zuhayrl/EEE4022S_Thesis/FinalReport/Main.tex

% Zuhayr Loonat - University of Cape Town - LNTZUH001
% This is a project report templace document created for EEE4022FS students at the University of Cape Town.
% This file should be is processed with ``pdflatex`` and might need a few modifications if a different processor is chosen.
% Use pdflatex - bibtex - pdf latex - pdflatex

\documentclass[a4paper,12pt]{report}

%Include packages you need to use here

\usepackage[top = 1in, bottom = 1in, left = 1in, right = 1in]{geometry}
\usepackage{graphicx}
\usepackage{fancyhdr}
\usepackage{amsmath, amsthm, amssymb}
\usepackage{lastpage}
\usepackage{subfigure}
\usepackage{lscape}
\usepackage{hyphenat}
\usepackage{setspace}
\usepackage{hyperref}
\usepackage{siunitx}
\usepackage{array}
\usepackage{float}

% Glossary package
% \usepackage[acronyms]{glossaries}
% \setacronymstyle{long-short}
\usepackage[acronym]{glossaries-extra}
\setabbreviationstyle[acronym]{long-short}
% \renewcommand{\acronymname}{Glossary}
\makenoidxglossaries

% Include glossary definitions
\input{glossary}

% Include page formatting here. 
\parskip=6mm
\parindent=0mm
\renewcommand{\headrulewidth}{0pt}
\rhead[]{\thesection}
\lhead[\thechapter]{}

\begin{document}

% This section formats the title page of the Report.
\thispagestyle{empty}
    {\Huge \begin{center}
        % Modify the line below to insert your title.
        The Measurement of Water Salinity \\for Antarctic Research
        %\hrule 
        % Modify the line below to insert your subtitle.
        %{\Large Insert a subtitle here (if applicable)}
    \end{center}}

    \vskip 5mm
    \begin{center}
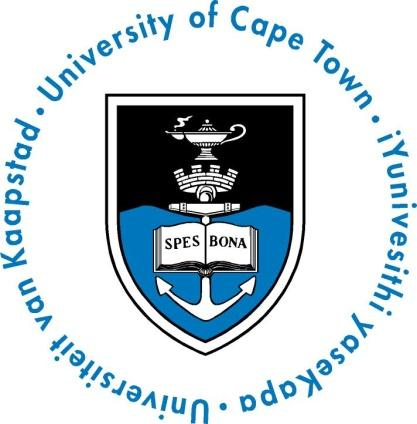
[picture p1: FinalReport/Figures/uctLogo.png]
        
    \end{center}

    \vskip 5mm
    \begin{center}
        Presented by:\\
        Zuhayr Loonat		% Insert your name here
    \end{center}

    \vskip 10mm
    \begin{center}
        Prepared for:\\
        Justin Pead\\ 		% Insert your supervisor's name here.
        Dept.~of Electrical Engineering\\University of Cape Town
    \end{center}

    \vskip 10mm
    \begin{center}
        Submitted to the Department of Electrical Engineering at the University of Cape Town in partial
        fulfillment of the academic requirements for a Bachelor of Science degree in Electrical and Computer Engineering
    \end{center}

    \vskip 5mm
    \begin{center}
        {\bf \today}
    \end{center}

%second Page
%\newpage
%\thispagestyle{empty}
%\mbox{}

% Declarartion
\fancyfoot[C]{\thepage}
\pagestyle{plain}
\newpage
\pagenumbering{roman}
%\newpage
    \onehalfspacing{
    \nohyphens{
    %\thispagestyle{empty}
    \vskip 40mm

    % Please leave the declaration as it is (Standard UCT declaration).
    {\Huge{Declaration}}\\
    %\hrule

    \vskip 10mm
    \begin{enumerate}
        \item I know that plagiarism is wrong.
        Plagiarism is to use another's work and pretend that it is one's own.
        \item I have used the IEEE convention for citation and referencing.
        Each contribution to, and quotation in, this report `The Measurement of Water Salinity for Antarctic Research' from the work{(s)} of other people has been attributed and has been cited and referenced.
        Any section taken from an internet source has been referenced to that source.
        \item This report `The Measurement of Water Salinity for Antarctic Research' is my own work and is in my own words (except where I have attributed it to others).
        \item I have not paid a third party to complete my work on my behalf.
        My use of artificial intelligence software has been limited to giving overviews of topics, checking grammar, and aiding with {\LaTeX} commands.
        \item I have not allowed and will not allow anyone to copy my work with the intention of passing it off as his or her own work.
        \item I acknowledge that copying someone else's assignment or essay, or part of it, is wrong, and declare that this is my own work
    \end{enumerate}
    \vskip30mm
        \begin{tabular*}{\textwidth}{@{}l@{\extracolsep{\fill}}r@{}}
        Signature:\ldots\ldots\ldots\ldots\ldots\ldots\ldots\ldots\ldots & Date: {\today} \\
        Zuhayr Loonat & \\
        Word Count: 10851& \\
        \end{tabular*}
        \vskip10mm

%\newpage
    %\thispagestyle{empty}
    %{\Huge Terms of Reference}\\
    %\hrule
    %\vskip 10mm
    %The terms of reference page is an agreement between yourself and your supervisor outlining what is expected of you in your final year project. Please make sure that this is discussed and written at the beginning of your thesis project. 

%\fancyfoot[C]{\thepage}
%\pagestyle{plain}
%\pagenumbering{roman}
\newpage
{\Huge Acknowledgments}\\
%\hrule
\vskip 10mm
I would like to express my sincere gratitude to my supervisor, Justin Pead, for his invaluable guidance, support, and expertise throughout this research.
His insights and encouragement were instrumental in bringing this work to fruition.

I am also deeply grateful to my friends for their unwavering moral support during this journey.
Their encouragement and understanding made the challenges of this process far more manageable.

Lastly, I would like to thank my family for their support during my studies.

\newpage
    {\Huge Abstract}\\
    %\hrule
    \vskip 10mm

    % Place your abstract here.
    Ice shelves form when glaciers flow from the Antarctic out over the ocean.
    This ice, which is originally freshwater ice is formed from accumulated snow, extends over the water and floats, because ice is less dense than water.
    When saltwater freezes at the bottom of the ice shelves, salt is expelled, forming a brine like solution, with a high salt density, directly under the ice shelves.

    The salinity of this brine solution and the seawater underneath need to be measured to aid in Antarctic research.
    This project documents the design and testing of a conductivity-based salinity measuring device to measure the salt content in these areas.
    The prototype was designed in two parts, a probe module, which would be lowered down through a water tower, which was drilled into the ice shelves, to measure the salinity, and a controller, which would be used to send instructions and receive data from the probe.
    The probe utilised gold electrodes to measure and analyse the salinity through conductivity.
    Two methods were investigated,~\gls{dc}, where point voltage measurements and voltage sweeps were conducted, and~\gls{ac} where a machine learning model was used to map properties of the input and output waves to a salinity value.
    The \gls{dc} method, using conductivity via resistance measurements over two probes, were able to produce salinity measurements within $\pm3.5$ \gls{psu}, but were subject to error and noise.
    The random forest algorithm used to predict permittivity of a Resistor-Capacitor circuit showed feasibility for salinity prediction use, where it showed capability for learning the physics, not just predicting based on random correlations.
    This feature identification carried over well, into the salinity prediction model. However, the prediction capabilities of this model were limited by the small dataset.

    With further testing, both the \gls{dc}, and \gls{ac} techniques could be improved to show more accurate results.

%\newpage
    %{\Huge Glossary}\\
    %\hrule
    %\vskip 10mm
    
    %\glsaddall

\newpage
    \tableofcontents

%\newpage
%\listoffigures

%\newpage
%\listoftables

% Page formatting, to place section titles as headers of odd pages and Chapter titles as headers of even pages.
%\newpage
%\fancyhead[RE,LO]{}
%\fancyhead[LE]{\leftmark}
%\fancyhead[RO]{\rightmark}
\pagestyle{fancy}

\pagenumbering{arabic}

% Print Glossary/Acronyms
\renewcommand{\acronymname}{Glossary}
\printnoidxglossaries

% THe files included below are .tex files containing the respective chapters these are already created in this package and you can add to or modify them.
\include{Body/Introduction}
\include{Body/Literature}
\include{Body/Methodology}
\include{Body/Results}
%\include{Body/Discussion}
\include{Body/Conclusions}
\include{Body/Recommendations}
\include{Referencing/References}
\appendix
\include{Appendix/appendixa}
\include{Appendix/appendixb}
\include{Appendix/appendixc}
}} % for nohyphens and line spacing
\end{document}
