zuhayrl/EEE4022S_Thesis/FinalReport/glossary.tex

% Glossary definitions for the thesis
% This file contains all glossary entries used throughout the document

% Physical quantities and units
\newacronym{psu}{PSU}{Practical Salinity Unit}
\newacronym{ppt}{‰}{Parts per thousand}

% Acronyms
\newacronym{eis}{EIS}{Electrochemical Impedance Spectroscopy}
\newacronym{ml}{ML}{Machine Learning}
\newacronym[shortplural=CTDs]{ctd}{CTD}{Conductivity, Temperature, Depth}
\newacronym[shortplural=PCBs]{pcb}{PCB}{Printed Circuit Board}
\newacronym{enig}{ENIG}{Electroless Nickel Immersion Gold}
\newacronym[shortplural=ADCs]{adc}{ADC}{Analogue to Digital Converter}
\newacronym[shortplural=DACs]{dac}{DAC}{Digital to Analogue Converter}
\newacronym{ac}{AC}{Alternating Current}
\newacronym{dc}{DC}{Direct Current}
\newacronym{ic}{IC}{Integrated Circuit}
\newacronym{uart}{UART}{Universal Asynchronous Receiver-Transmitter}
\newacronym{led}{LED}{Light Emitting Diode}
\newacronym[shortplural=EECs, longplural={Equivalent Electrical Circuits}]{eec}{EEC}{Equivalent Electrical Circuit}
\newacronym[shortplural=ANNs, longplural={Artificial Neural Networks}]{ann}{ANN}{Artificial Neural Network}
