zuhayrl/EEE4022S_Thesis/FinalReport/Appendix/appendixb.tex

\chapter{Addenda}

\section{Examples of AI Usage}

\begin{figure}[H]
    \centering
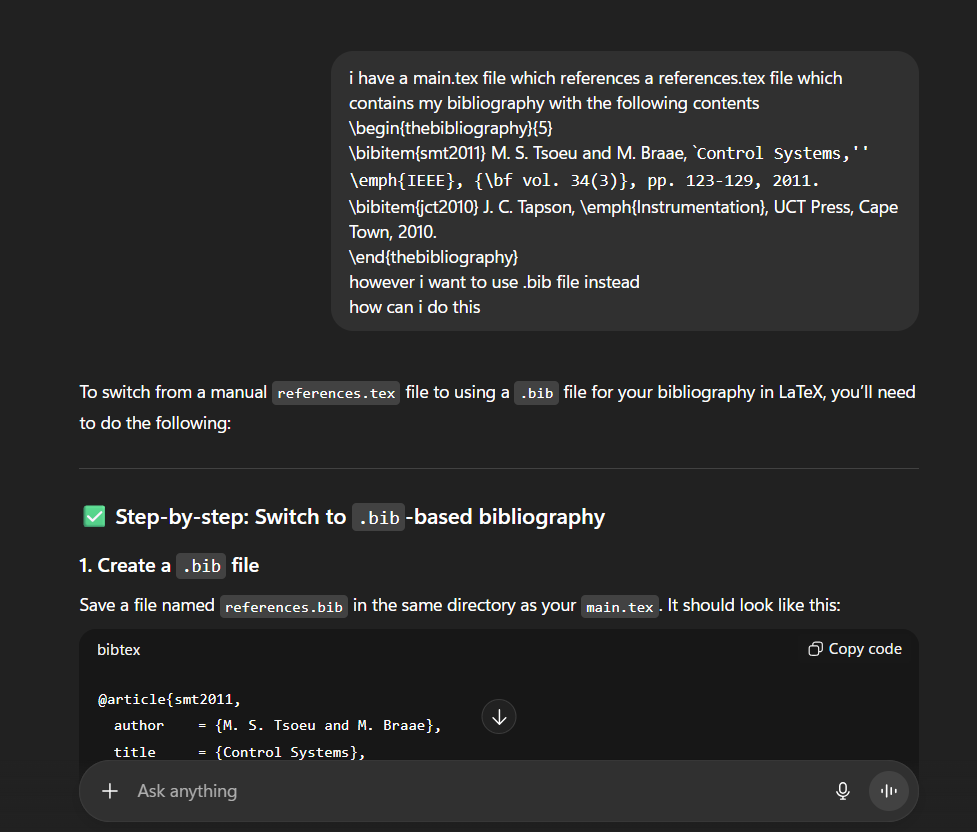
[picture p12: FinalReport/Figures/AI_Usage/Bib_file.png]
    
    \caption{Latex Referencing}
\end{figure}

\begin{figure}[H]
    \centering
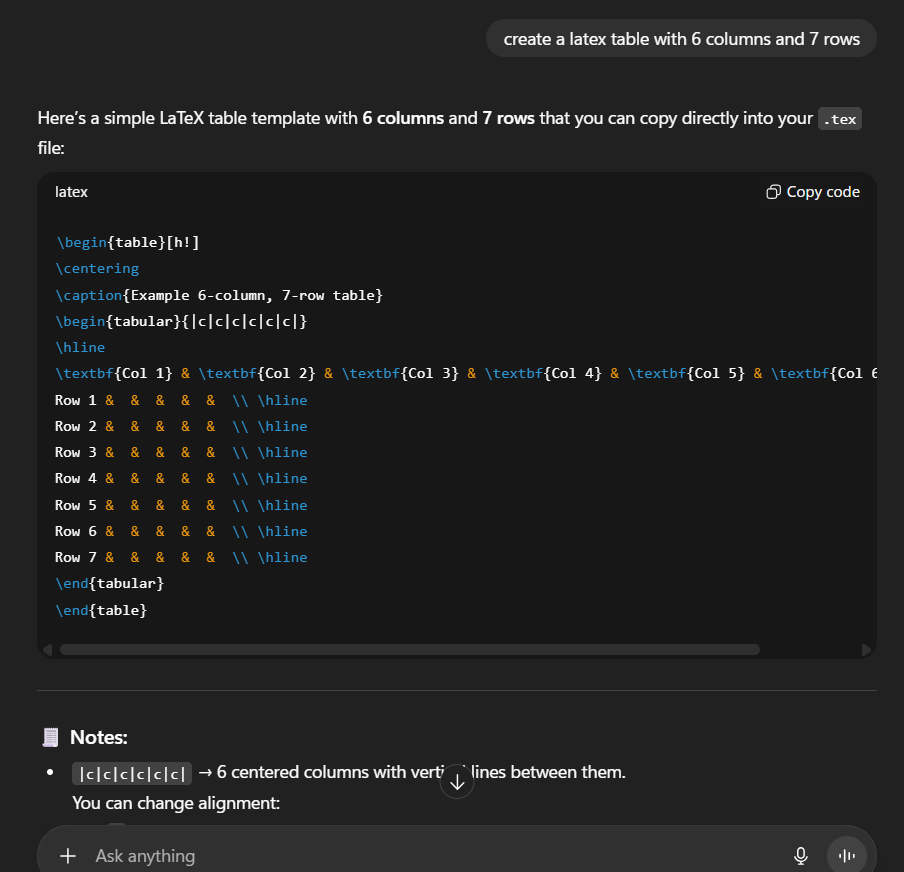
[picture p13: FinalReport/Figures/AI_Usage/latex_table.png]
    
    \caption{Latex Formatting}
\end{figure}

\begin{figure}[H]
    \centering
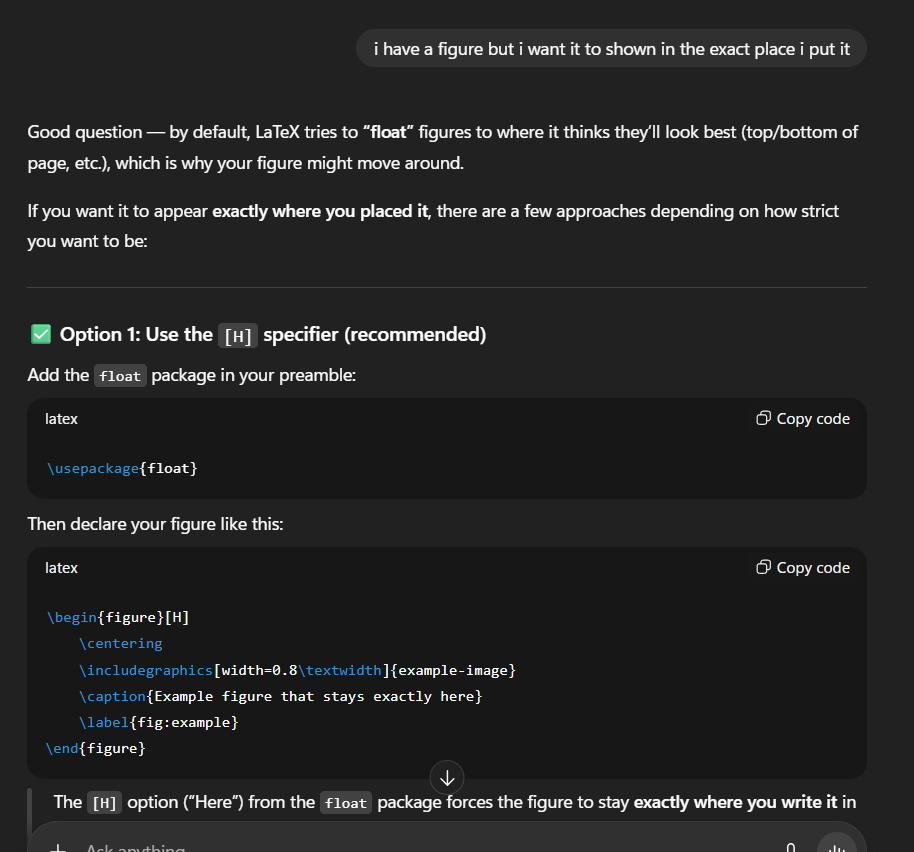
[picture p14: FinalReport/Figures/AI_Usage/latex_figure.png]
    
    \caption{Latex Formatting}
\end{figure}

\begin{figure}[H]
    \centering
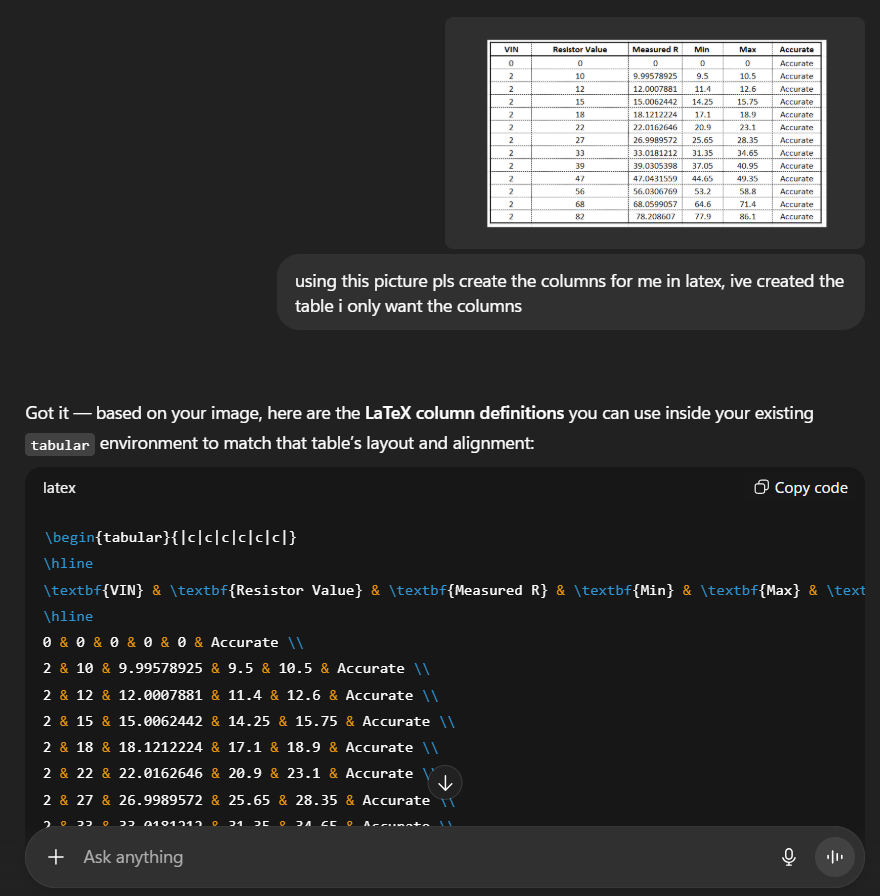
[picture p15: FinalReport/Figures/AI_Usage/latex_pic.png]
    
    \caption{Latex Formatting}
\end{figure}

\begin{figure}[H]
    \centering
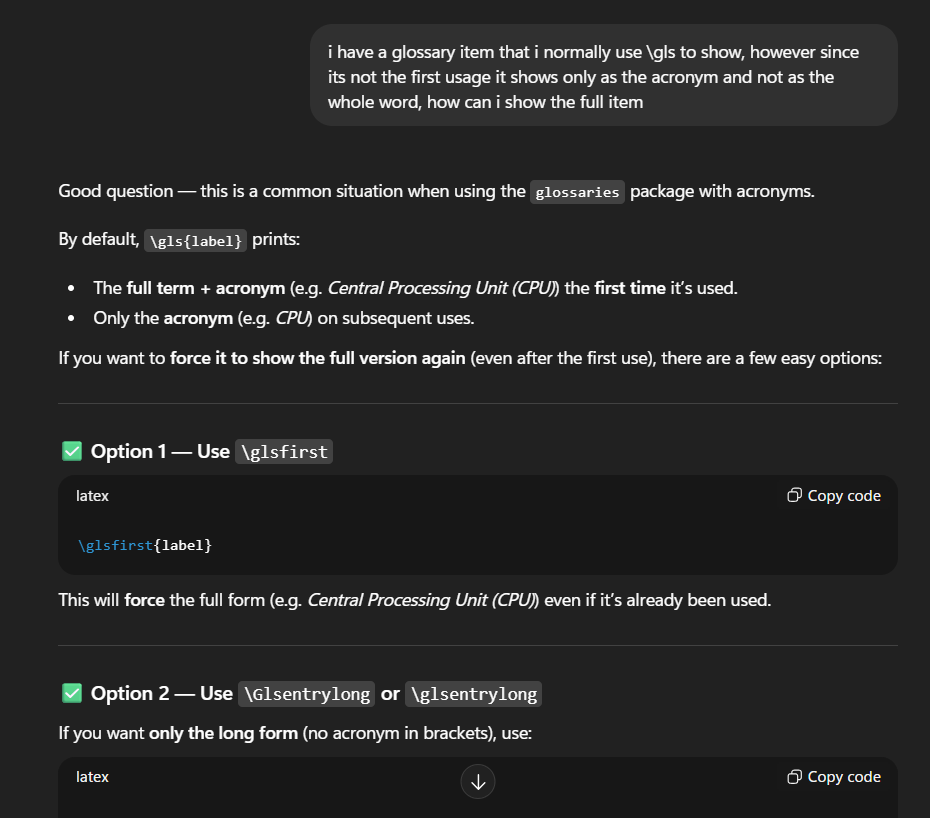
[picture p16: FinalReport/Figures/AI_Usage/latex_gls.png]
    
    \caption{Latex Formatting}
\end{figure}

\begin{figure}[H]
    \centering
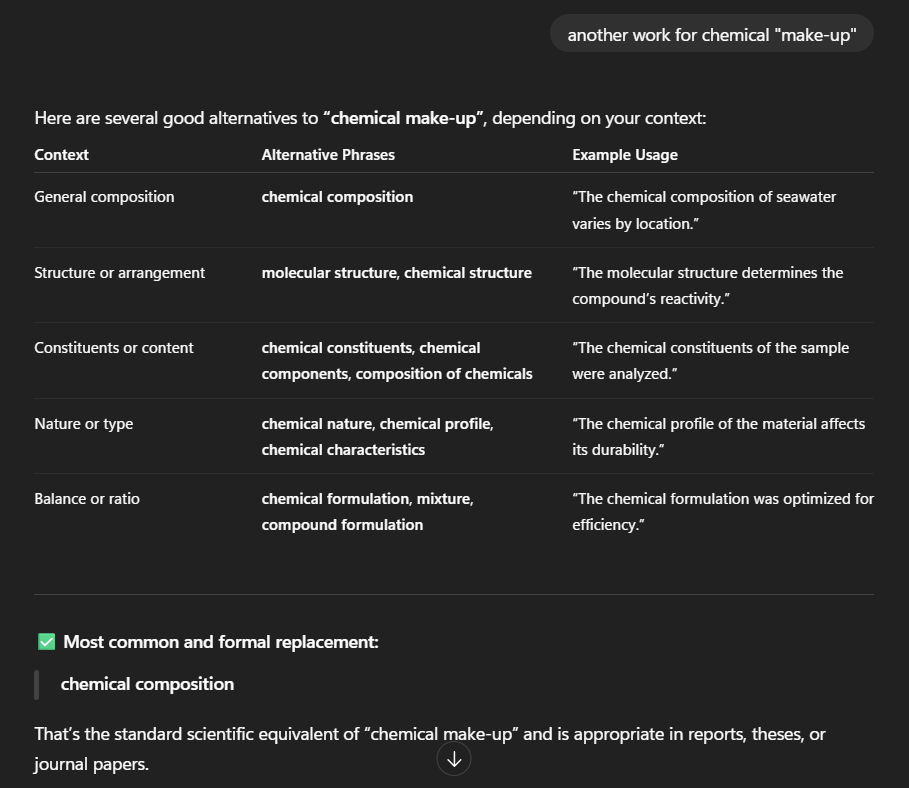
[picture p17: FinalReport/Figures/AI_Usage/grammar1.png]
    
    \caption{Grammar}
    \textit{Note: Grammarly was also used for spelling and grammar checks}
\end{figure}

\begin{figure}[H]
    \centering
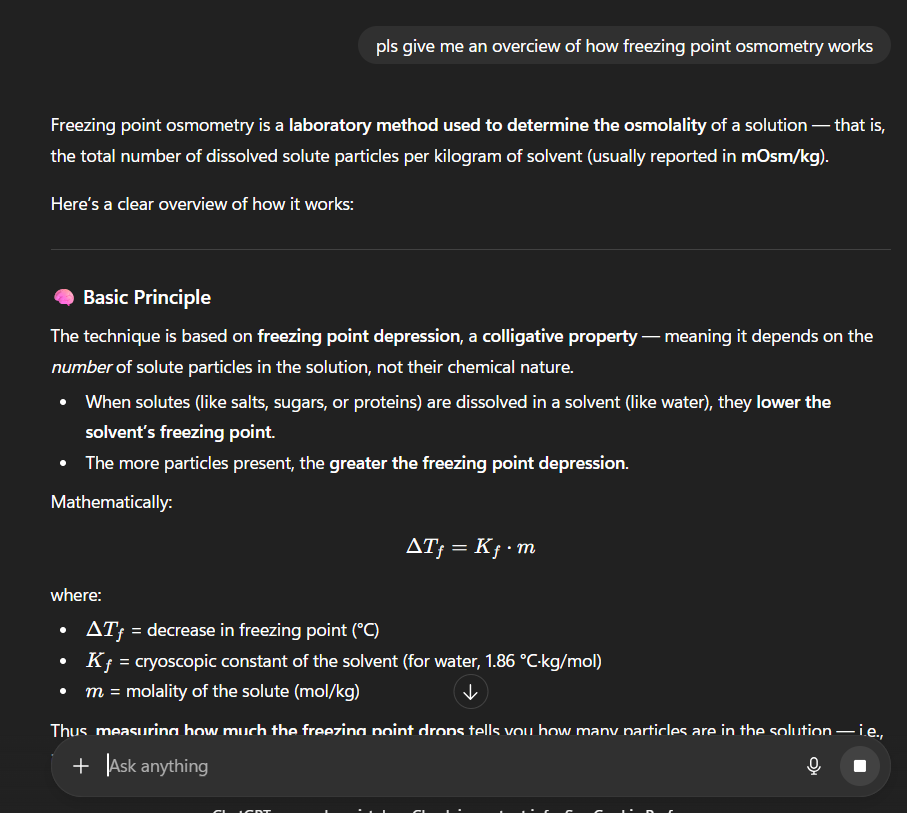
[picture p18: FinalReport/Figures/AI_Usage/freezing_overview.png]
    
    \caption{Topic Overview}
\end{figure}

\begin{figure}[H]
    \centering
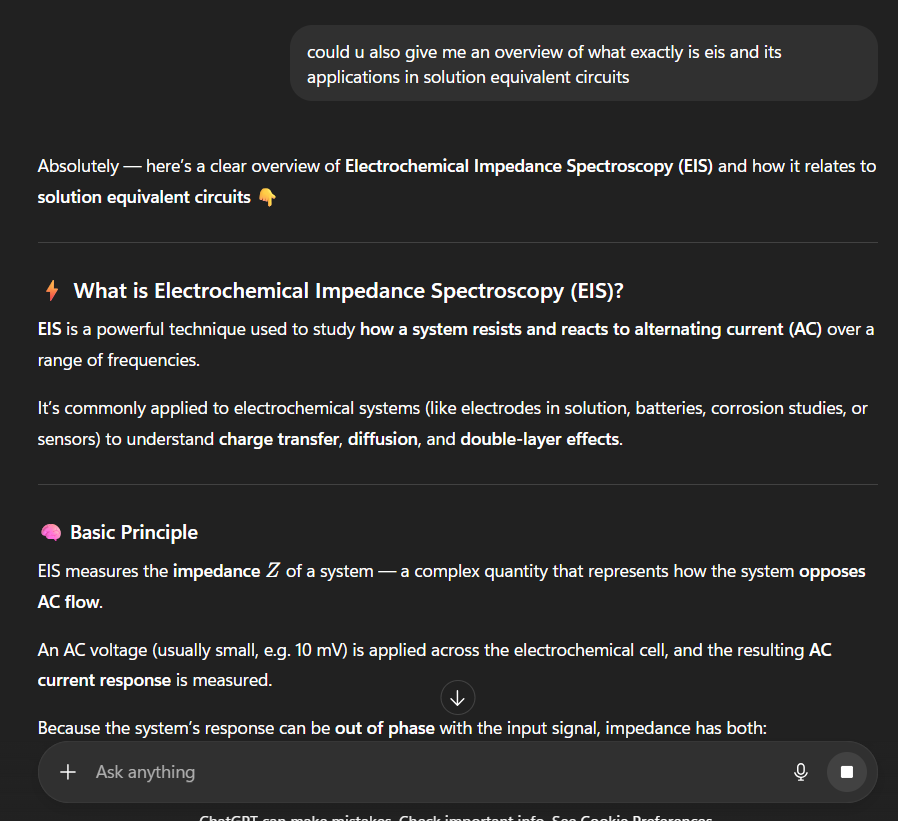
[picture p19: FinalReport/Figures/AI_Usage/eis_overview.png]
    
    \caption{Topic Overview}
\end{figure}
