zuhayrl/EEE4022S_Thesis/PCB/Order/Total.png

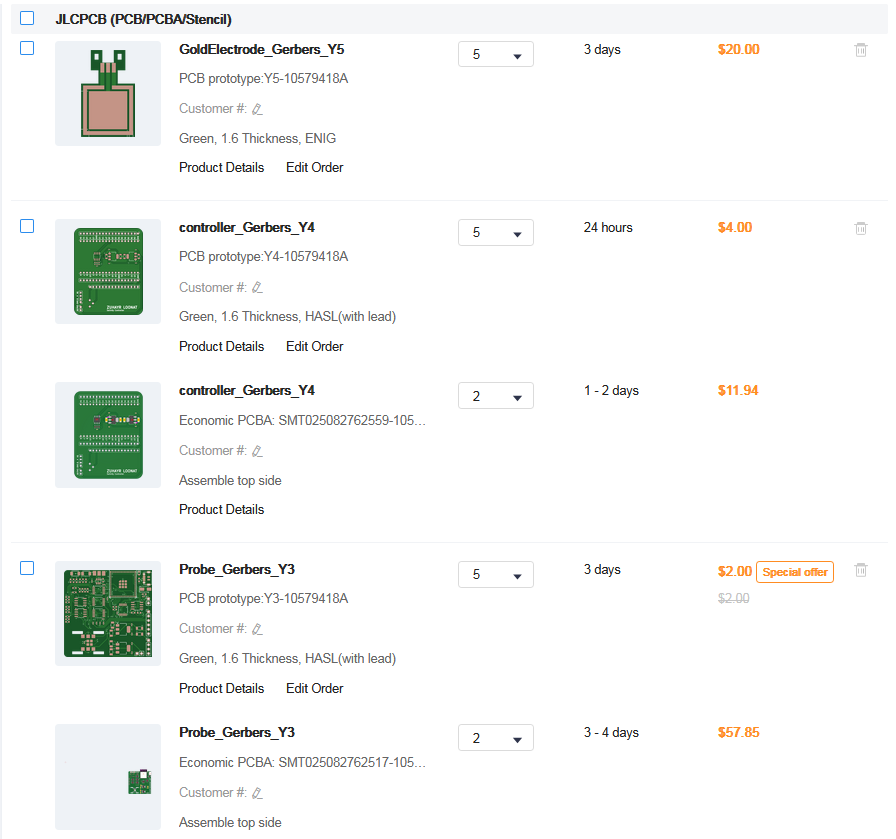
PCB/Order/Total.png
