zuhayrl/EEE4022S_Thesis/Testing/SalinityTesting.xlsx

Sheet: DAC Testing
Instructed | Multimeter | Gain | ADC UNB | Calib | Gain | ADC DAC | Calib | Gain
0.0 | 0.0098 | 0.00980 | 0.003 | 0 | 0.00300 | 0.004 | 0 | 0.00400
0.1 | 0.1158 | 1.15800 | 0.157 | 0.6369426752 | 1.57000 | 0.143 | 0.6993006993 | 1.43000
0.2 | 0.2158 | 1.07900 | 0.279 | 0.7168458781 | 1.39500 | 0.269 | 0.7434944238 | 1.34500
0.3 | 0.3158 | 1.05267 | 0.396 | 0.7575757576 | 1.32000 | 0.391 | 0.7672634271 | 1.30333
0.4 | 0.413 | 1.03250 | 0.533 | 0.7504690432 | 1.33250 | 0.517 | 0.7736943907 | 1.29250
0.5 | 0.51 | 1.02000 | 0.658 | 0.7598784195 | 1.31600 | 0.648 | 0.7716049383 | 1.29600
0.6 | 0.612 | 1.02000 | 0.781 | 0.7682458387 | 1.30167 | 0.77 | 0.7792207792 | 1.28333
0.7 | 0.711 | 1.01571 | 0.909 | 0.7700770077 | 1.29857 | 0.898 | 0.7795100223 | 1.28286
0.8 | 0.81 | 1.01250 | 1.031 | 0.7759456838 | 1.28875 | 1.021 | 0.7835455436 | 1.27625
0.9 | 0.899 | 0.99889 | 1.152 | 0.78125 | 1.28000 | 1.145 | 0.7860262009 | 1.27222
1.0 | 1.005 | 1.00500 | 1.27 | 0.7874015748 | 1.27000 | 1.268 | 0.7886435331 | 1.26800
1.1 | 1.103 | 1.00273 | 1.404 | 0.7834757835 | 1.27636 | 1.394 | 0.7890961263 | 1.26727
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
