zuhayrl/EEE4022S_Thesis/FinalReport/Figures/resistance_test_table.png

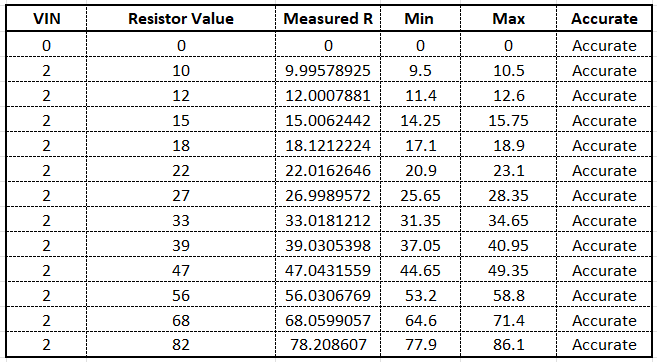
FinalReport/Figures/resistance_test_table.png
