zuhayrl/EEE4022S_Thesis/MachineLearning/Salinity_ML/salinity_model_results.png

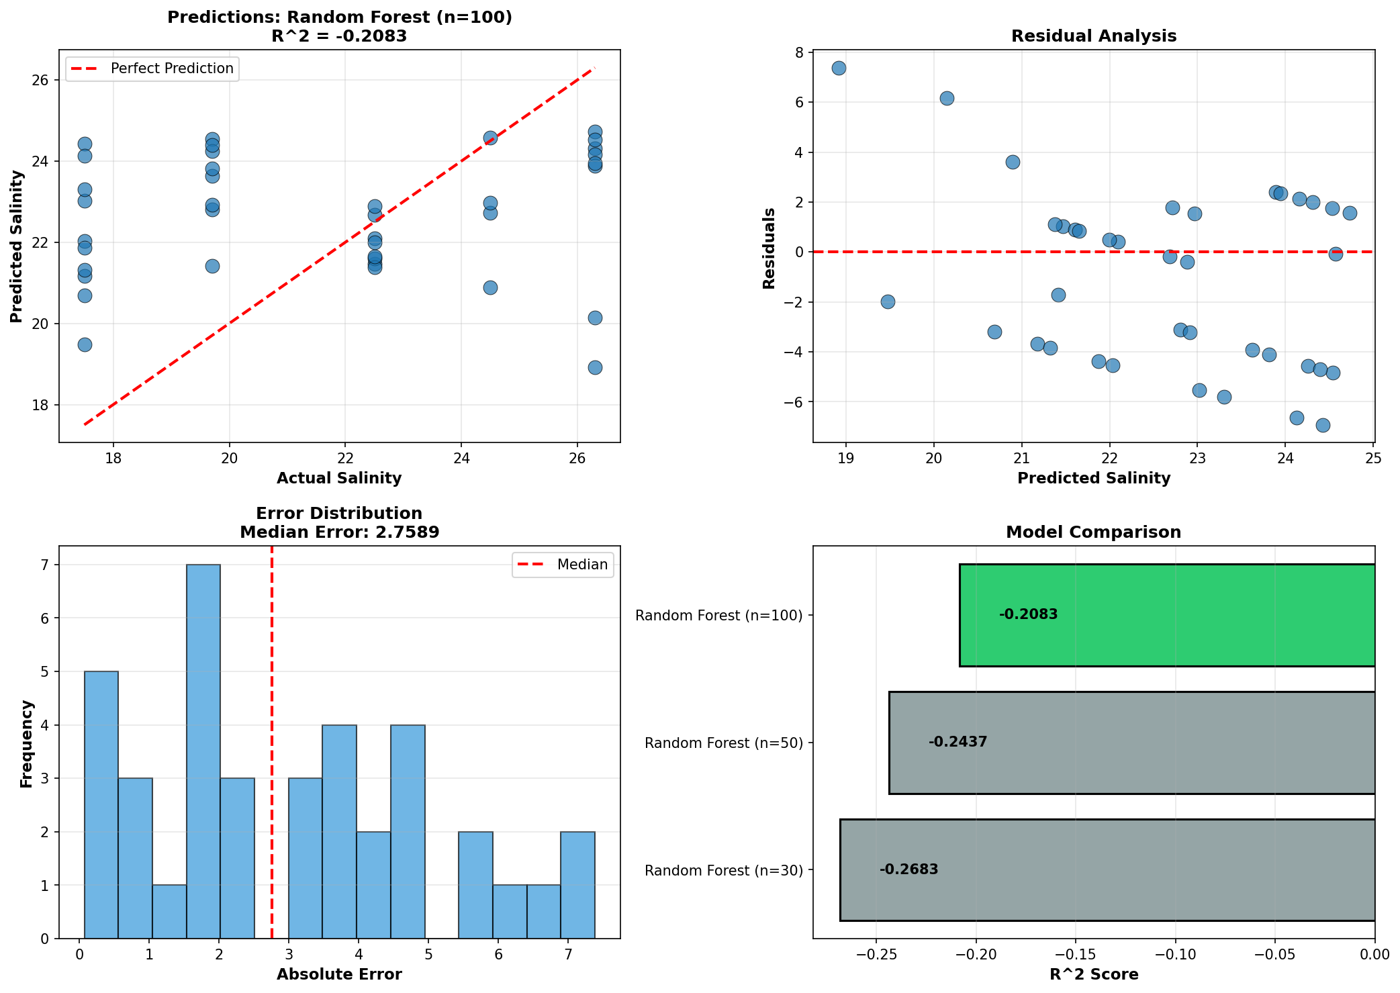
MachineLearning/Salinity_ML/salinity_model_results.png
