zuhayrl/EEE4022S_Thesis/Testing/Bode/1hz.png

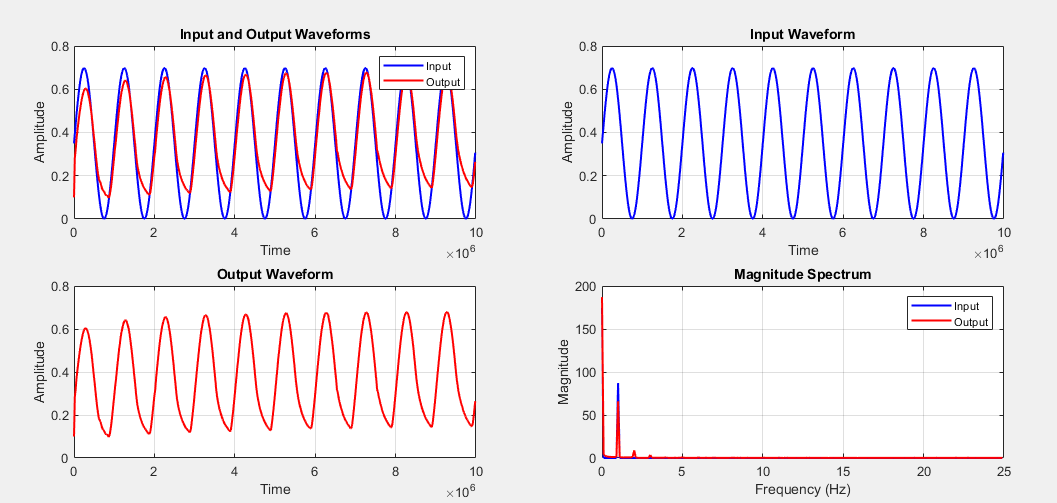
Testing/Bode/1hz.png
