zuhayrl/EEE4022S_Thesis/Testing/Bode/2hz.png

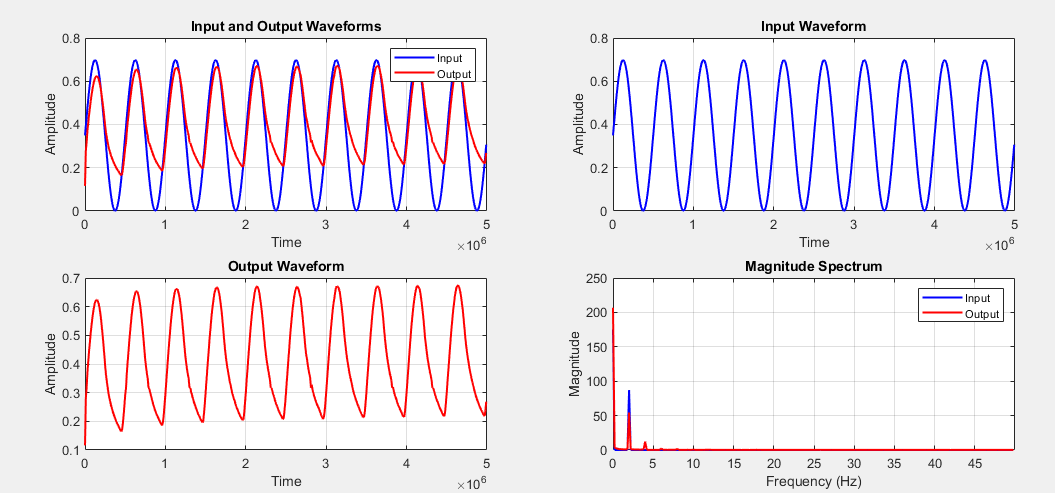
Testing/Bode/2hz.png
