zuhayrl/EEE4022S_Thesis/Testing/Bode/3hz.png

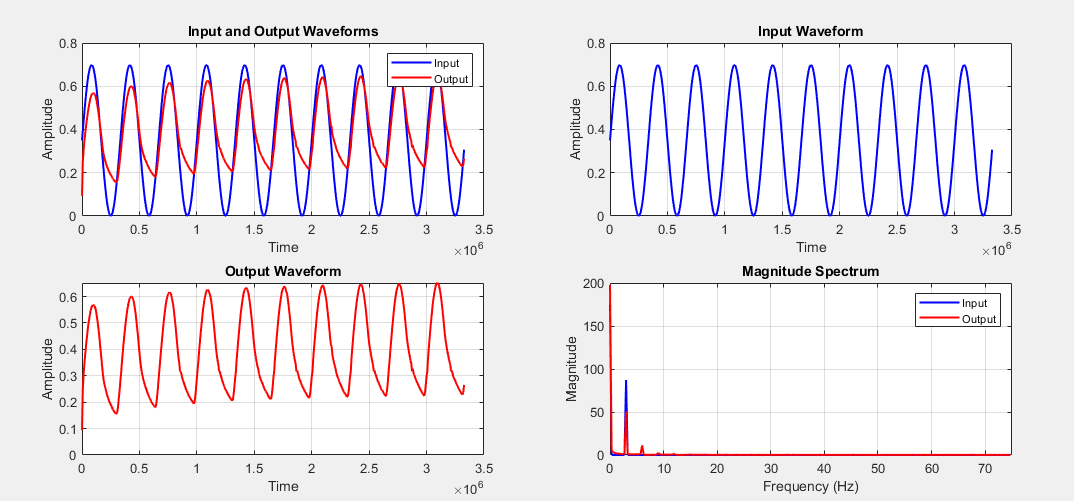
Testing/Bode/3hz.png
