zuhayrl/EEE4022S_Thesis/Testing/Bode/4hz.png

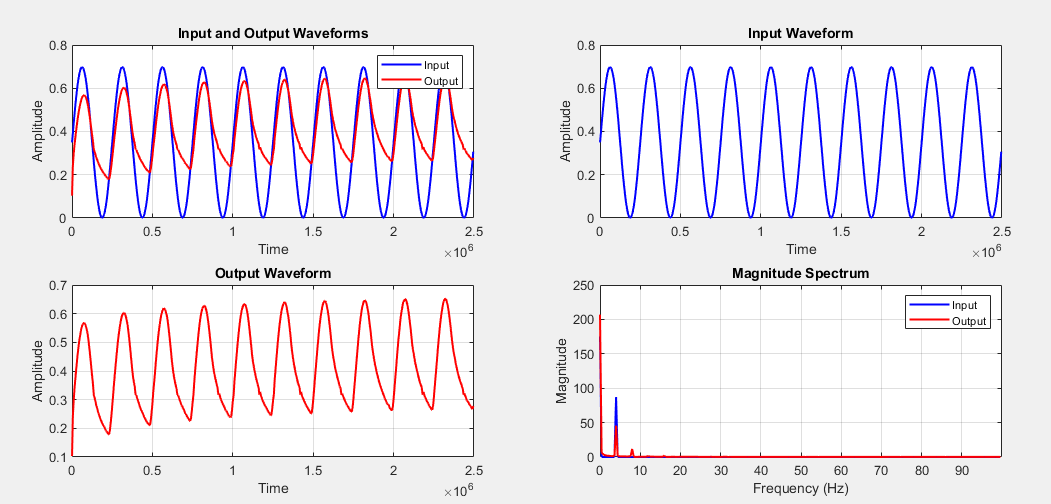
Testing/Bode/4hz.png
