zuhayrl/EEE4022S_Thesis/Testing/Bode/5hz.png

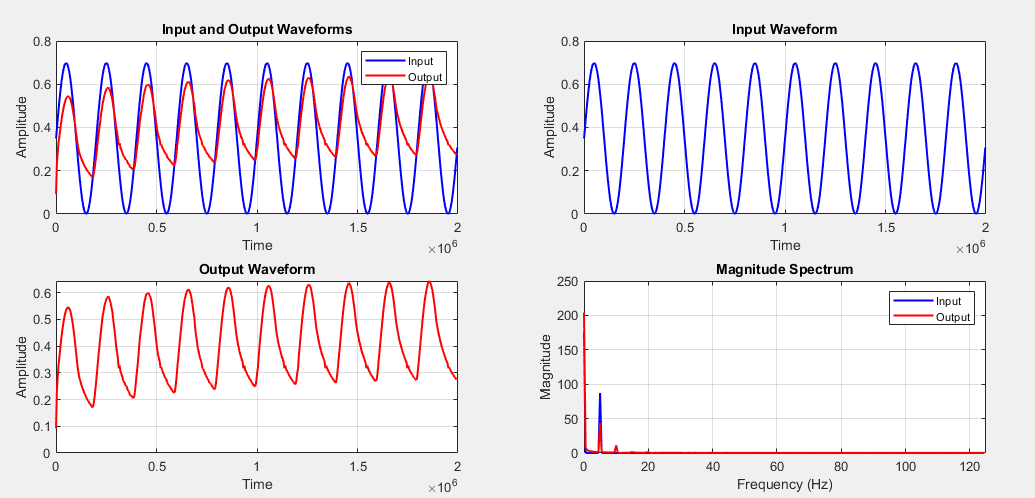
Testing/Bode/5hz.png
