zuhayrl/EEE4022S_Thesis/Testing/Bode/6hz.png

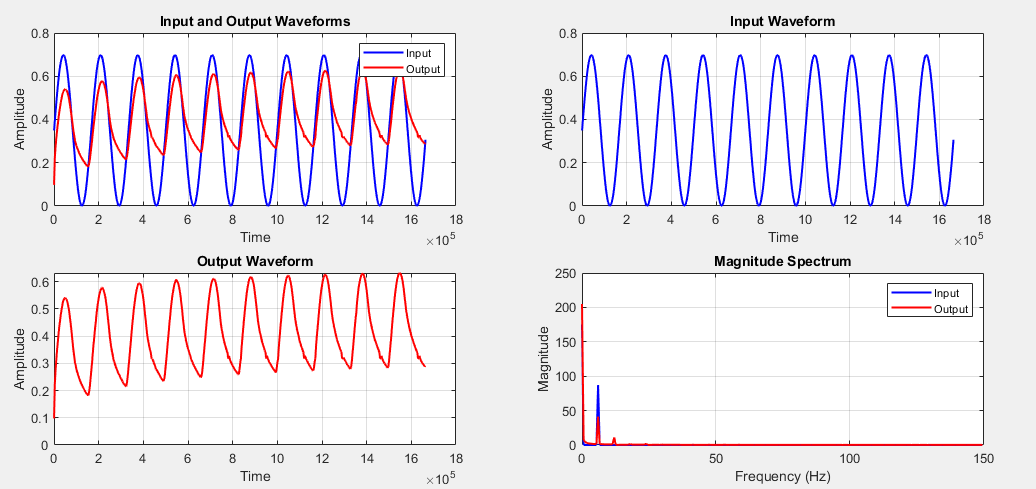
Testing/Bode/6hz.png
