zuhayrl/EEE4022S_Thesis/Testing/Bode/7hz.png

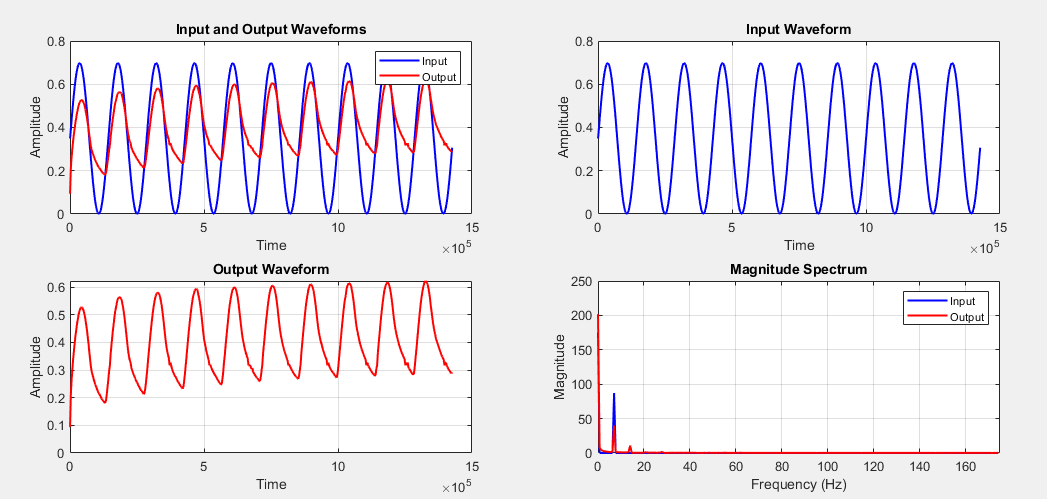
Testing/Bode/7hz.png
