zuhayrl/EEE4022S_Thesis/Testing/Bode/8hz.png

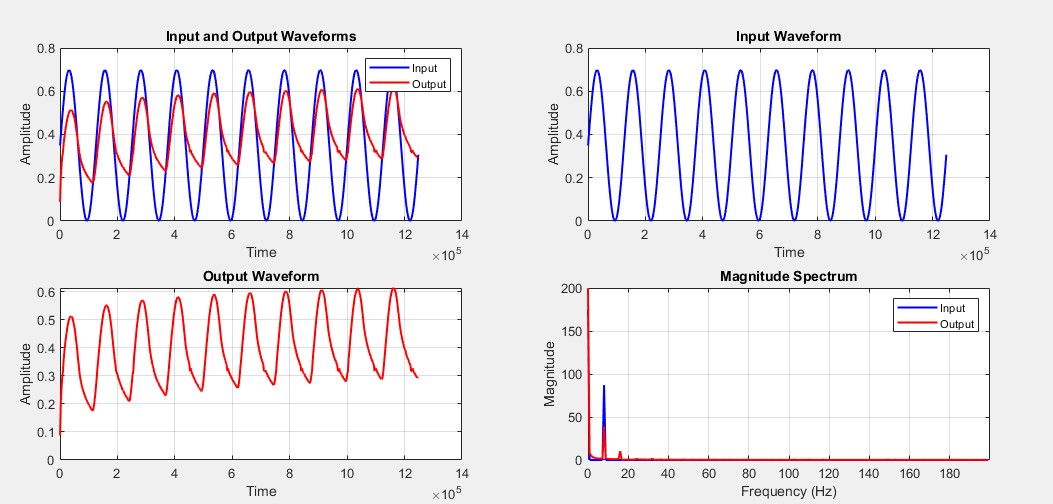
Testing/Bode/8hz.png
