zuhayrl/EEE4022S_Thesis/Testing/Bode/9hz.png

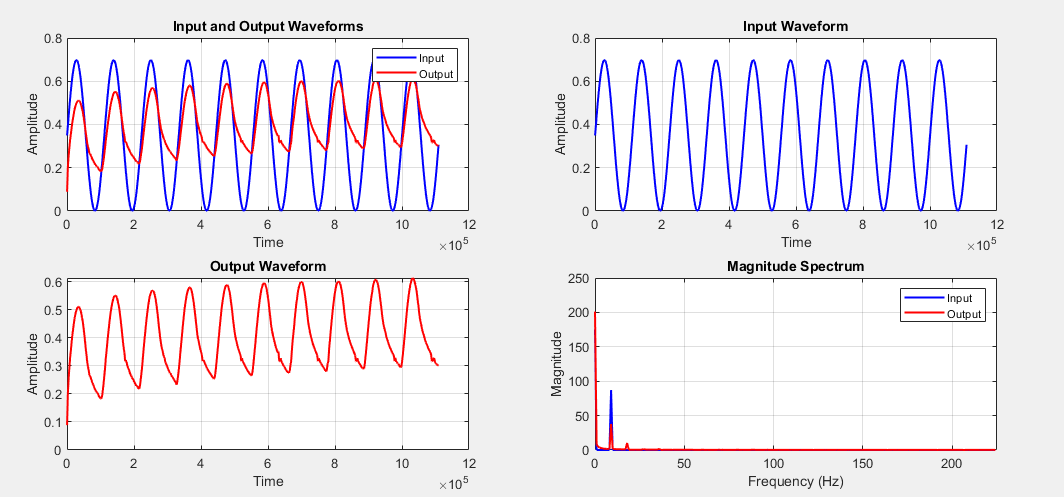
Testing/Bode/9hz.png
