zuhayrl/EEE4022S_Thesis/Testing/Bode/10hz.png

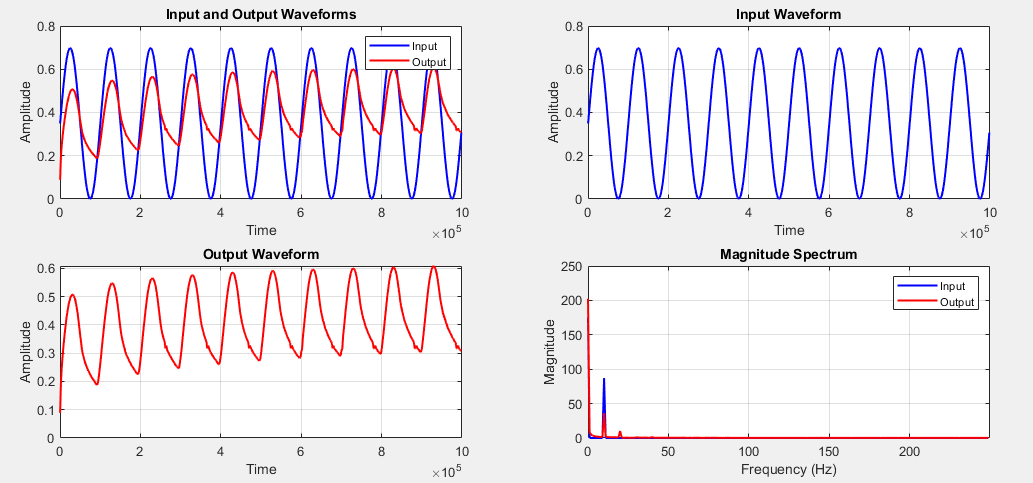
Testing/Bode/10hz.png
