zuhayrl/EEE4022S_Thesis/Testing/Bode/11hz.png

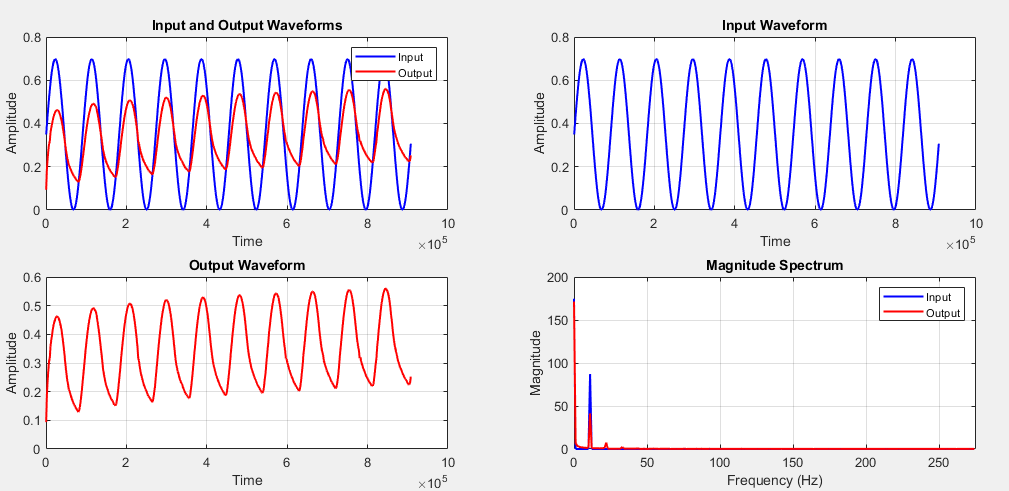
Testing/Bode/11hz.png
