zuhayrl/EEE4022S_Thesis/Testing/Bode/12hz.png

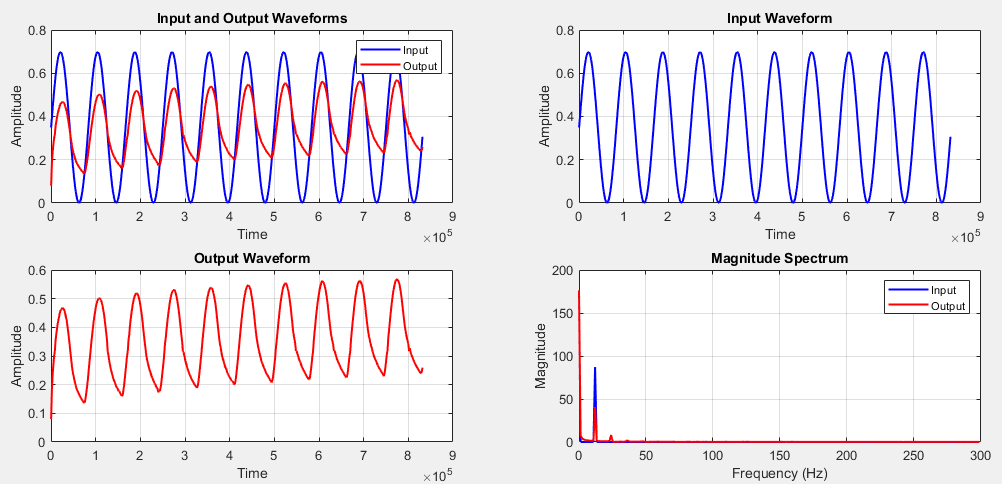
Testing/Bode/12hz.png
