zuhayrl/EEE4022S_Thesis/Testing/Bode/13hz.png

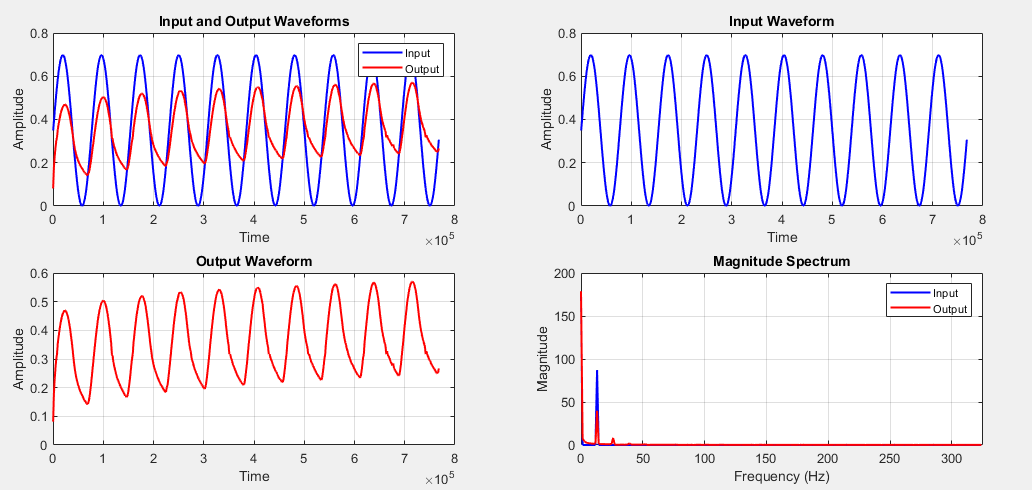
Testing/Bode/13hz.png
