zuhayrl/EEE4022S_Thesis/Testing/Bode/14hz.png

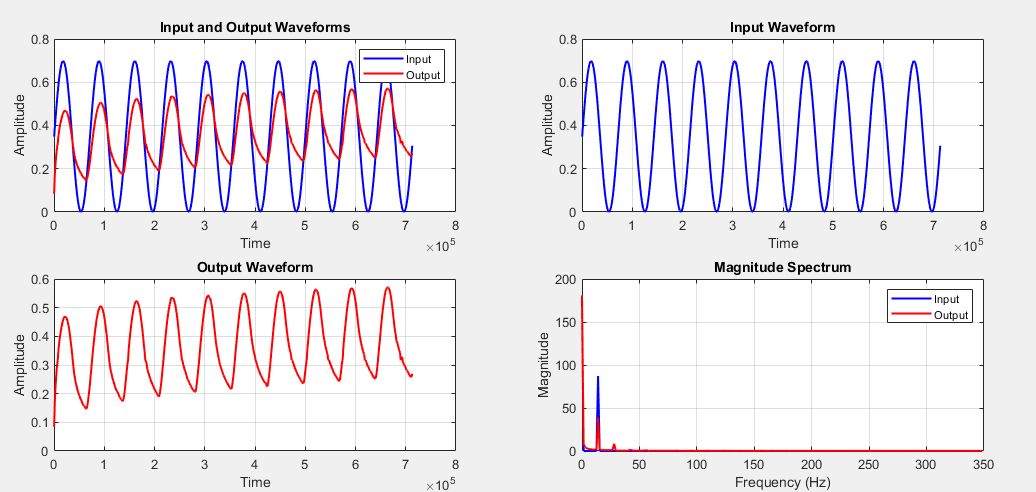
Testing/Bode/14hz.png
