zuhayrl/EEE4022S_Thesis/Testing/Bode/17hz.png

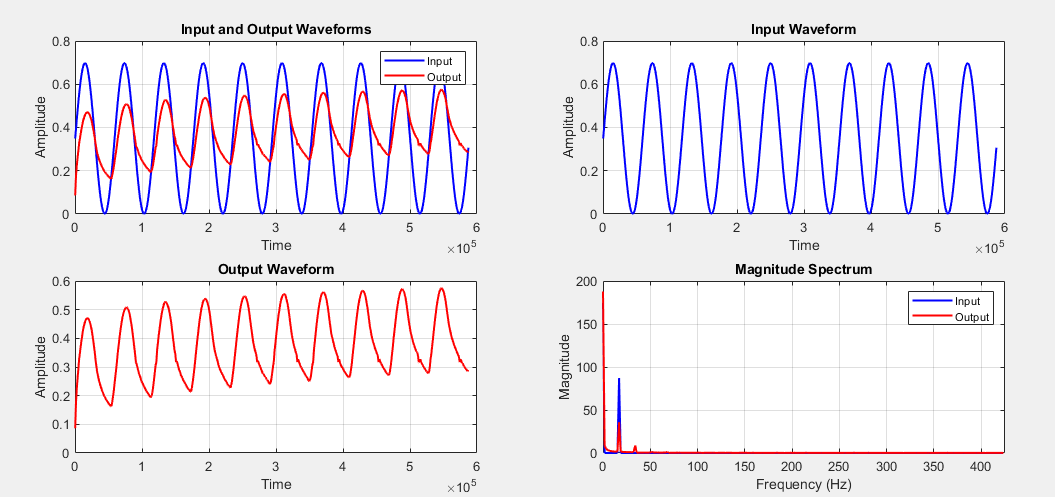
Testing/Bode/17hz.png
