zuhayrl/EEE4022S_Thesis/Testing/Bode/19hz.png

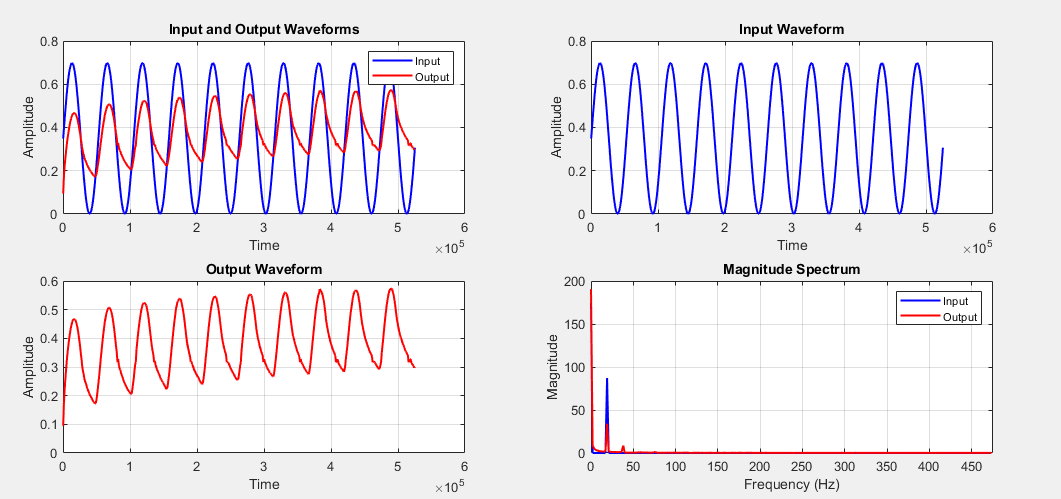
Testing/Bode/19hz.png
