zuhayrl/EEE4022S_Thesis/Testing/Bode/20hz.png

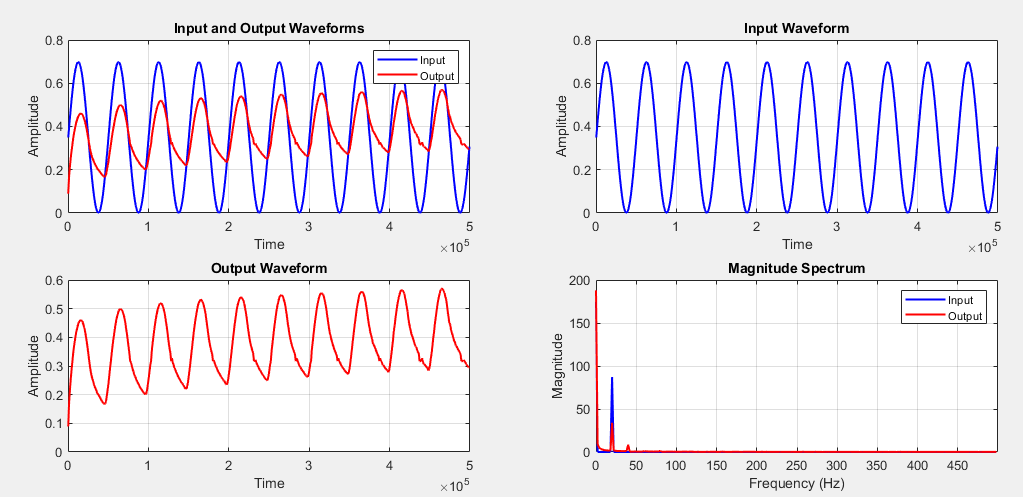
Testing/Bode/20hz.png
