zuhayrl/EEE4022S_Thesis/PCB/Probe/probe_v5-0/probe.pdf

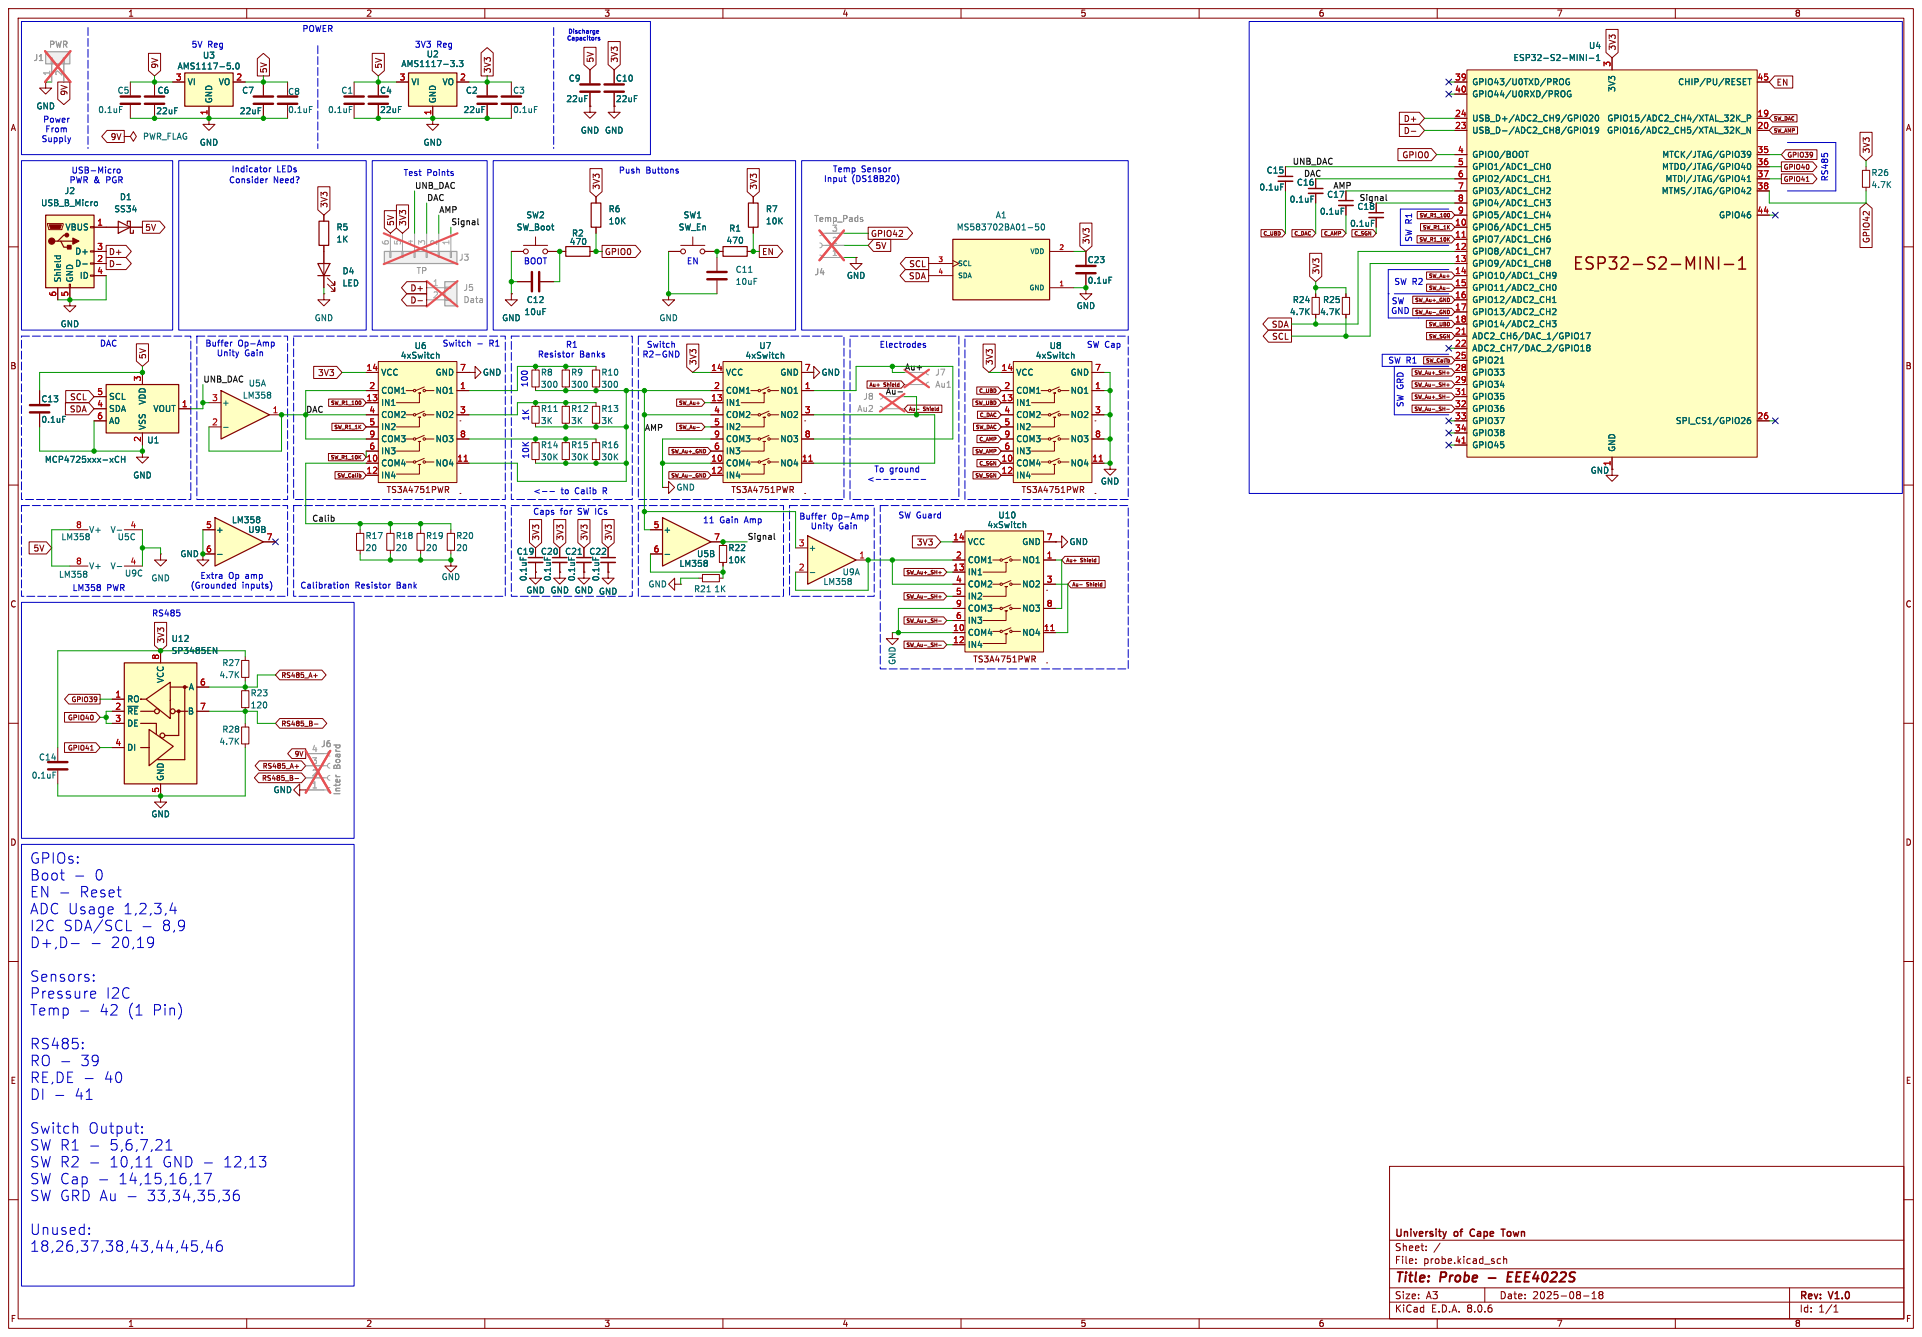
[picture p52: page 1]

1 VO 2 VI 3 GND GND

3 SDA 4 SCL 5 A0 6 U1 MCP4725xxx-xCH GND
