zuhayrl/EEE4022S_Thesis/PCB/Probe/probe_v1-0/probe.pdf

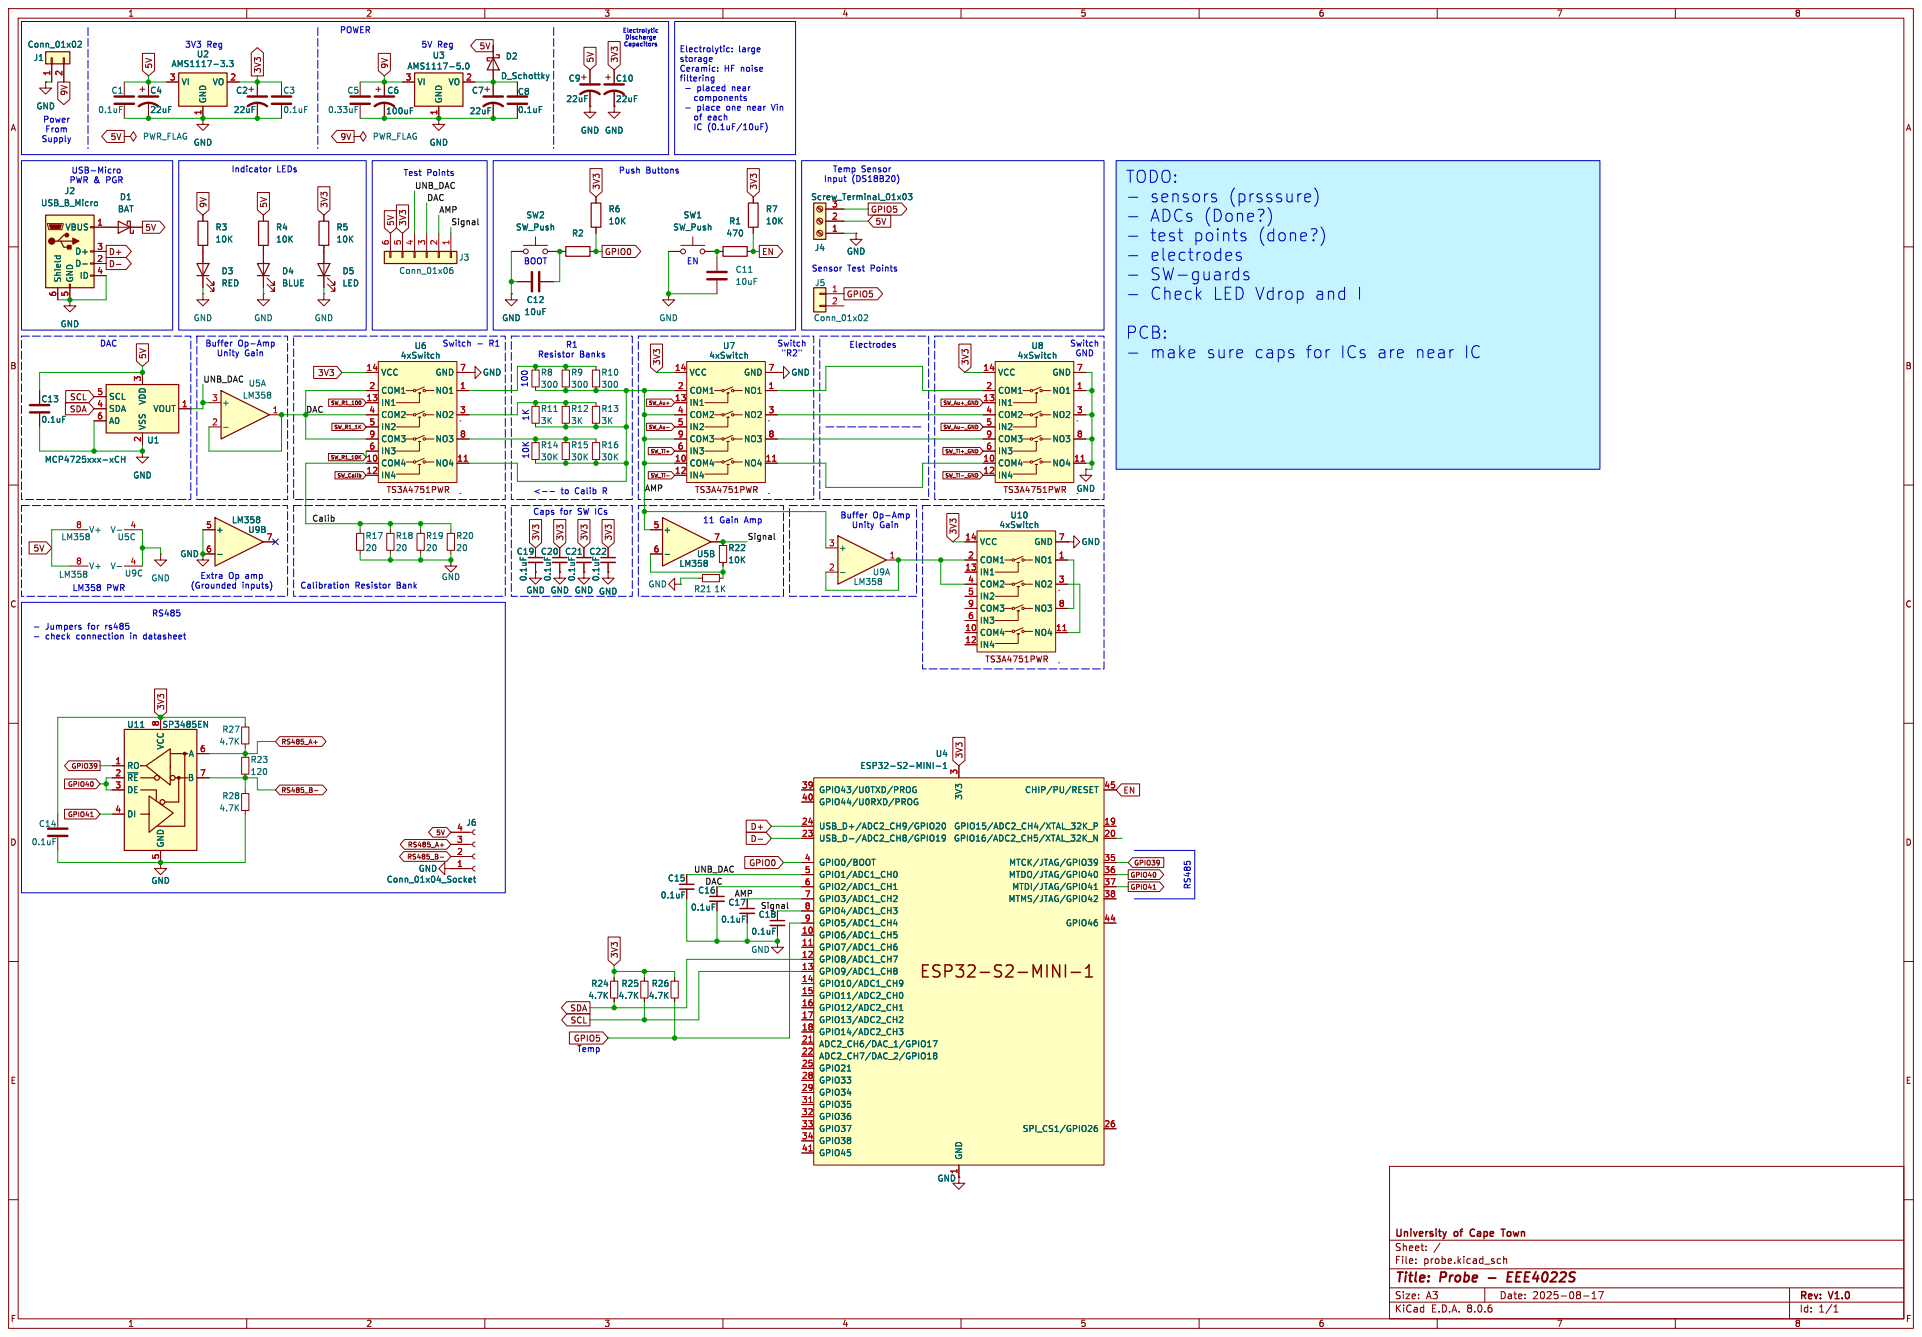
[picture p53: page 1]

Electrolytic Discharge Capacitors Push Buttons Switch - R1 Test Points Extra Op amp

storage Ceramic: HF noise

- place one near Vin
of each

- ADCs (Done?)
- test points (done?)
- electrodes
- SW-guards
- Check LED Vdrop and I

PCB: - make sure caps for ICs are near IC

3 SDA 4 SCL 5 A0 6 U1 MCP4725xxx-xCH GND

3 GPIO35 31 GPIO36 32 GPIO37 33 GPIO38 34 MTCK/JTAG/GPIO39 35 MTDO/JTAG/GPIO40 36 MTDI/JTAG/GPIO41 37 MTMS/JTAG/GPIO42 38 GPIO43/U0TXD/PROG 39 GPIO0/BOOT 4 GPIO44/U0RXD/PROG 40 GPIO45 41 GPIO1/ADC1_CH0 5 GPIO2/ADC1_CH1 6 GPIO3/ADC1_CH2 7 GPIO4/ADC1_CH3 8 GPIO5/ADC1_CH4 9 U4 ESP32-S2-MINI-1 GND

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
