zuhayrl/EEE4022S_Thesis/PCB/Probe/probe_v5-0/probe.kicad_pcb

## KiCad design PCB/Probe/probe_v5-0/probe.kicad_pcb (2025-09-24)

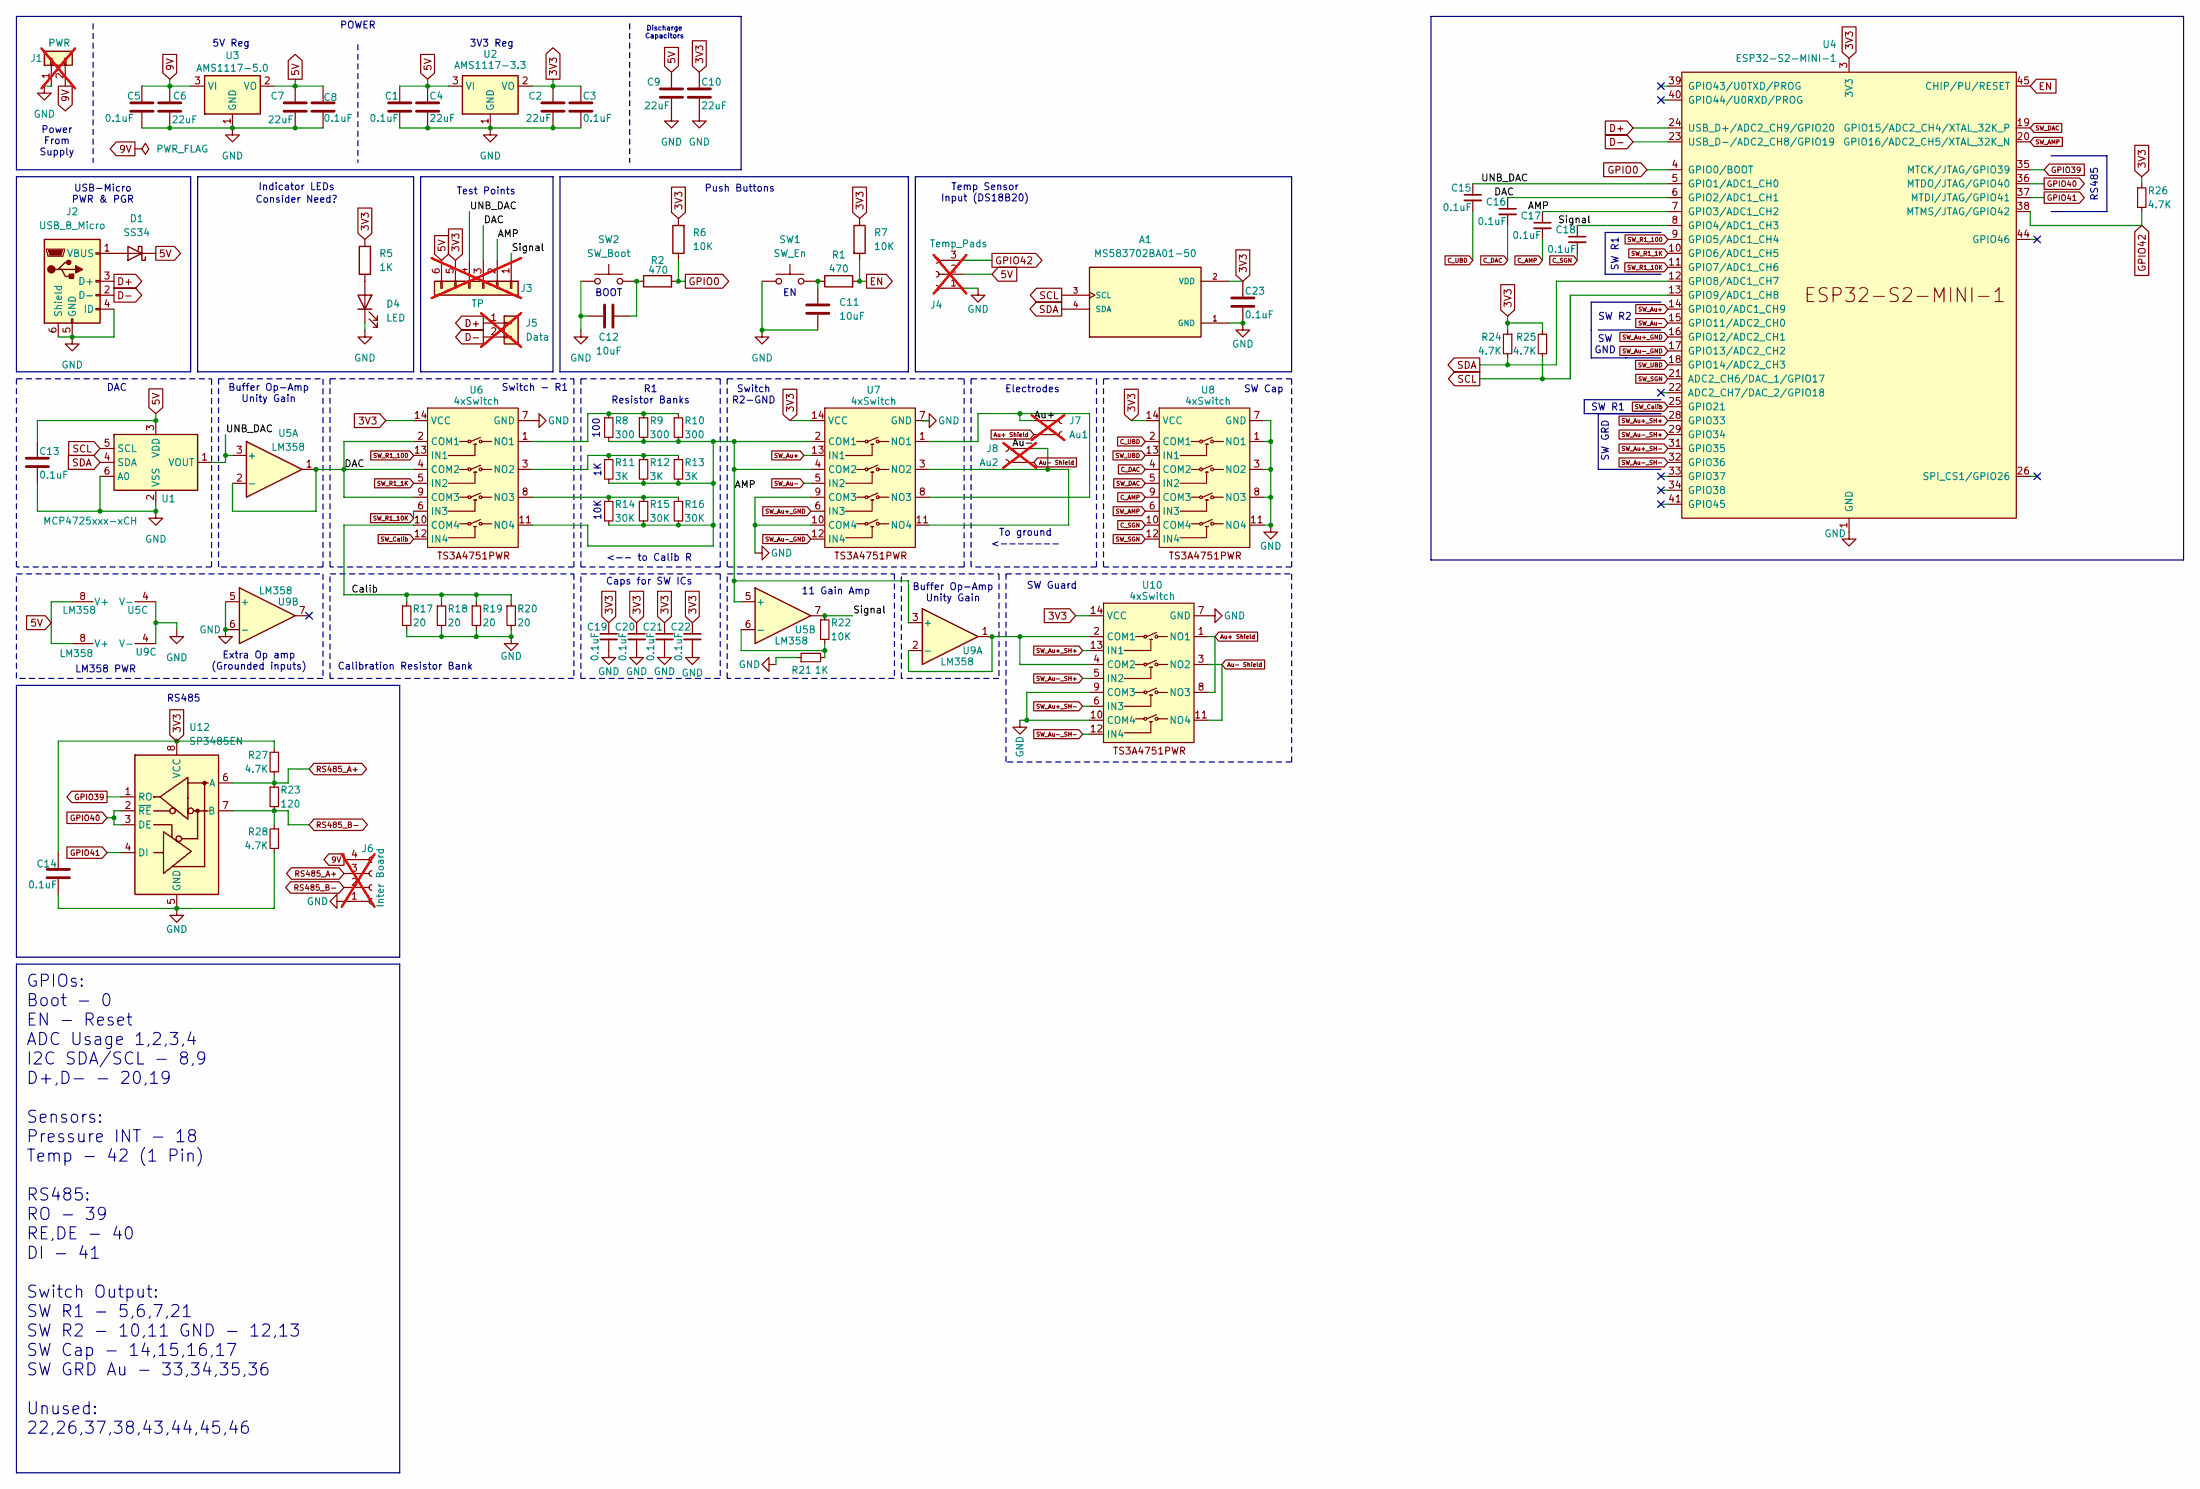
[picture p54: schematic probe.kicad_sch, Probe - EEE4022S]

Parts:
A1: MS583702BA01-50; XDCR_MS583702BA01-50; PARTREV A8; JLC Part no. C5785272
C1, C3, C5, C8, C13, C14, C15, C16, C17, C18, C19, C20, C21, C22, C23: 0.1uF; C_0402_1005Metric; JLC Part no. C1525
C2, C4, C6, C7, C9, C10: 22uF; C_1206_3216Metric; JLC Part no. C12891
C11, C12: 10uF; C_0603_1608Metric; JLC Part no. C19702
D1: SS34; D_SMA; JLC Part no. C8678
D4: LED; LED_0603_1608Metric; JLC Part no. C2286
J1: PWR; PinHeader_1x02_P2.54mm_Vertical; not fitted
J2: USB_B_Micro; SHOUHAN_MICROXNJ_Edited; JLC Part no. C404969
J3: TP; PinHeader_1x06_P2.54mm_Vertical; not fitted
J4: Temp_Pads; 3-Wire Solder Pads; not fitted
J5: Data; PinHeader_1x02_P2.54mm_Vertical; not fitted
J6: Inter Board; PinHeader_1x04_P2.54mm_Vertical; not fitted
J7: Au1; Au_Electrode_edited_1; not fitted
J8: Au2; Au_Electrode_edited_1; not fitted
R1, R2: 470; R_0603_1608Metric; JLC Part no. C23179
R5, R21: 1K; R_0603_1608Metric; JLC Part no. C21190
R6, R7, R22: 10K; R_0603_1608Metric; JLC Part no. C25804
R8, R9, R10: 300; R_0603_1608Metric; JLC Part no. C23025
R11, R12, R13: 3K; R_0603_1608Metric; JLC Part no. C4211
R14, R15, R16: 30K; R_0603_1608Metric; JLC Part no. C22984
R17, R18, R19, R20: 20; R_0603_1608Metric; JLC Part no. C22950
R23: 120; R_0603_1608Metric; JLC Part no. C22787
R24, R25, R26, R27, R28: 4.7K; R_0603_1608Metric; JLC Part no. C23162
SW1: SW_En; SW_TS-1088-AR02016; JLC Part no. C720477
SW2: SW_Boot; SW_TS-1088-AR02016; JLC Part no. C720477
U1: MCP4725xxx-xCH; SOT-23-6; JLC Part no. C144198
U2: AMS1117-3.3; SOT-223-3_TabPin2; JLC Part no. C6186
U3: AMS1117-5.0; SOT-223-3_TabPin2; JLC Part no. C6187
U4: ESP32-S2-MINI-1; JLC Part no. C3013906
U5, U9: LM358; SOIC-8_3.9x4.9mm_P1.27mm; JLC Part no. C7950
U6, U7, U8, U10: 4xSwitch; TSSOP-14_4.4x5mm_P0.65mm; JLC Part no. C128399
U12: SP3485EN; SOIC-8_3.9x4.9mm_P1.27mm; JLC Part no. C8963

Connections:
3V3: A1.2 (VDD), C2.1, C3.1, C10.1, C14.1, C19.1, C20.1, C21.1, C22.1, C23.1, J3.5, R5.2, R6.2, R7.1, R24.1, R25.1, R26.1, R27.1, U2.2 (VO), U4.3 (3V3), U6.14 (VCC), U7.14 (VCC), U8.14 (VCC), U10.14 (VCC), U12.8 (VCC)
5V: C1.1, C4.1, C7.1, C8.1, C9.1, C13.1, D1.1 (K), J3.6, J4.2, U1.3 (VDD), U2.3 (VI), U3.2 (VO), U5.8 (V+), U9.8 (V+)
9V: C5.1, C6.1, J1.2, J6.4, U3.3 (VI)
/AMP: C17.1, J3.2, R8.2, R9.2, R10.2, R11.2, R12.2, R13.2, R14.2, R15.2, R16.2, U4.7 (GPIO3/ADC1_CH2), U5.5 (+), U6.11 (NO4), U7.2 (COM1), U7.4 (COM2), U9.3 (+)
/Au+: J7.1, U7.1 (NO1), U7.8 (NO3)
/Au-: J8.1, U7.3 (NO2), U7.11 (NO4)
/Calib: R17.1, R18.1, R19.1, R20.1, U6.10 (COM4)
/DAC: C16.1, J3.3, U4.6 (GPIO2/ADC1_CH1), U5.1, U5.2 (-), U6.2 (COM1), U6.4 (COM2), U6.9 (COM3)
/Signal: C18.1, J3.1, R22.1, U4.8 (GPIO4/ADC1_CH3), U5.7
/UNB_DAC: C15.1, J3.4, U1.1 (VOUT), U4.5 (GPIO1/ADC1_CH0), U5.3 (+)
Au+ Shield: J7.2, U10.1 (NO1), U10.8 (NO3)
Au- Shield: J8.2, U10.3 (NO2), U10.11 (NO4)
C_AMP: C17.2, U8.9 (COM3)
C_DAC: C16.2, U8.4 (COM2)
C_SGN: C18.2, U8.10 (COM4)
C_UBD: C15.2, U8.2 (COM1)
D+: J2.3 (D+), J5.1, U4.24 (USB_D+/ADC2_CH9/GPIO20)
D-: J2.2 (D-), J5.2, U4.23 (USB_D-/ADC2_CH8/GPIO19)
EN: R1.2, R7.2, U4.45 (CHIP/PU/RESET)
GND: A1.1 (GND), C1.2, C2.2, C3.2, C4.2, C5.2, C6.2, C7.2, C8.2, C9.2, C10.2, C11.2, C12.2, C13.2, C14.2, C19.2, C20.2, C21.2, C22.2, C23.2, D4.1 (K), J1.1, J2.4 (ID), J2.5 (GND), J2.6 (Shield), J4.1, J6.1, R17.2, R18.2, R19.2, R20.2, R21.1, R28.2, SW1.1, SW2.1, U1.2 (VSS), U1.6 (A0), U2.1 (GND), U3.1 (GND), U4.1 (GND), U4.2 (GND), U4.30 (GND), U4.42 (GND), U4.43 (GND), U4.46 (GND), U4.47 (GND), U4.48 (GND), U4.49 (GND), U4.50 (GND), U4.51 (GND), U4.52 (GND), U4.53 (GND), U4.54 (GND), U4.55 (GND), U4.56 (GND), U4.57 (GND), U4.58 (GND), U4.59 (GND), U4.60 (GND), U4.61 (GND), U4.62 (GND), U4.63 (GND), U4.64 (GND), U4.65 (GND), U5.4 (V-), U6.7 (GND), U7.7 (GND), U7.9 (COM3), U7.10 (COM4), U8.1 (NO1), U8.3 (NO2), U8.7 (GND), U8.8 (NO3), U8.11 (NO4), U9.4 (V-), U9.5 (+), U9.6 (-), U10.7 (GND), U10.9 (COM3), U10.10 (COM4), U12.5 (GND)
GPIO0: R2.2, R6.1, U4.4 (GPIO0/BOOT)
GPIO39: U4.35 (MTCK/JTAG/GPIO39), U12.1 (RO)
GPIO40: U4.36 (MTDO/JTAG/GPIO40), U12.2 (~RE), U12.3 (DE)
GPIO41: U4.37 (MTDI/JTAG/GPIO41), U12.4 (DI)
GPIO42: J4.3, R26.2, U4.38 (MTMS/JTAG/GPIO42)
unnamed: C11.1, R1.1, SW1.2
unnamed: C12.1, R2.1, SW2.2
unnamed: D1.2 (A), J2.1 (VBUS)
unnamed: D4.2 (A), R5.1
unnamed: R21.2, R22.2, U5.6 (-)
unnamed: R8.1, R9.1, R10.1, U6.1 (NO1)
unnamed: R11.1, R12.1, R13.1, U6.3 (NO2)
unnamed: R14.1, R15.1, R16.1, U6.8 (NO3)
unnamed: U9.1, U9.2 (-), U10.2 (COM1), U10.4 (COM2)
RS485_A+: J6.3, R23.1, R27.2, U12.6 (A)
RS485_B-: J6.2, R23.2, R28.1, U12.7 (B)
SCL: A1.3 (SCL), R25.2, U1.5 (SCL), U4.13 (GPIO9/ADC1_CH8)
SDA: A1.4 (SDA), R24.2, U1.4 (SDA), U4.12 (GPIO8/ADC1_CH7)
SW_AMP: U4.20 (GPIO16/ADC2_CH5/XTAL_32K_N), U8.6 (IN3)
SW_Au+: U4.14 (GPIO10/ADC1_CH9), U7.13 (IN1)
SW_Au+_GND: U4.16 (GPIO12/ADC2_CH1), U7.6 (IN3)
SW_Au+_SH+: U4.28 (GPIO33), U10.13 (IN1)
SW_Au+_SH-: U4.31 (GPIO35), U10.6 (IN3)
SW_Au-: U4.15 (GPIO11/ADC2_CH0), U7.5 (IN2)
SW_Au-_GND: U4.17 (GPIO13/ADC2_CH2), U7.12 (IN4)
SW_Au-_SH+: U4.29 (GPIO34), U10.5 (IN2)
SW_Au-_SH-: U4.32 (GPIO36), U10.12 (IN4)
SW_Calib: U4.25 (GPIO21), U6.12 (IN4)
SW_DAC: U4.19 (GPIO15/ADC2_CH4/XTAL_32K_P), U8.5 (IN2)
SW_R1_1K: U4.10 (GPIO6/ADC1_CH5), U6.5 (IN2)
SW_R1_10K: U4.11 (GPIO7/ADC1_CH6), U6.6 (IN3)
SW_R1_100: U4.9 (GPIO5/ADC1_CH4), U6.13 (IN1)
SW_SGN: U4.21 (ADC2_CH6/DAC_1/GPIO17), U8.12 (IN4)
SW_UBD: U4.18 (GPIO14/ADC2_CH3), U8.13 (IN1)

Notes on the sheet:
GPIOs: Boot - 0 EN - Reset ADC Usage 1,2,3,4 I2C SDA/SCL - 8,9 D+,D- - 20,19 Sensors: Pressure INT - 18 Temp - 42 (1 Pin) RS485: RO - 39 RE,DE - 40 DI - 41 Switch Output: SW R1 - 5,6,7,21 SW R2 - 10,11 GND - 12,13 SW Cap - 14,15,16,17 SW GRD Au - 33,34,35,36 Unused: 22,26,37,38,43,44,45,46
Extra Op amp (Grounded inputs)
Switch - R1
Calibration Resistor Bank
BOOT
SW R1
Test Points
5V Reg
POWER
SW GND
Discharge Capacitors
SW Cap
3V3 Reg
LM358 PWR
USB-Micro PWR & PGR
To ground <-------
Push Buttons
SW R2
DAC
Consider Need?
10K
SW GRD
Electrodes
RS485
Buffer Op-Amp Unity Gain
Temp Sensor Input (DS18B20)
100
Indicator LEDs
Switch R2-GND
SW Guard
Caps for SW ICs
<-- to Calib R
Power From Supply
11 Gain Amp
R1 Resistor Banks

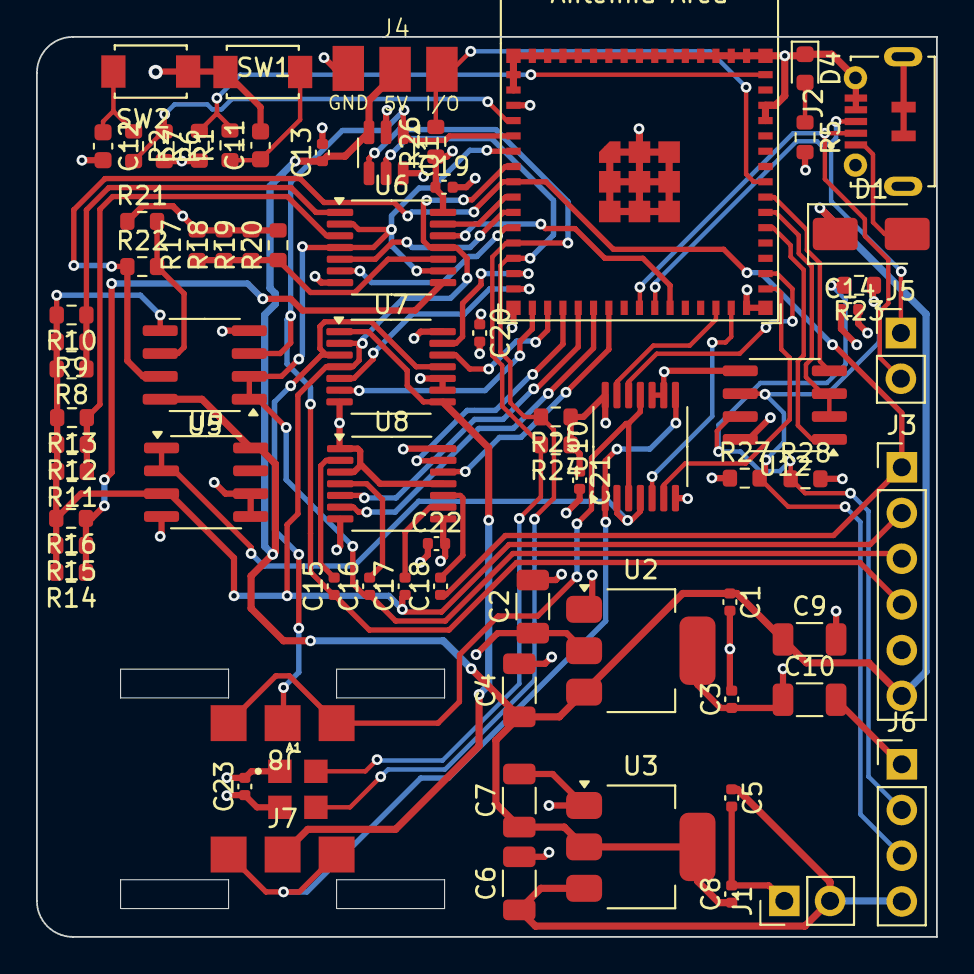
[picture p55: board probe.kicad_pcb from above]

Board: 4 copper layers, 50.0 x 50.0 mm, 73 parts (0 on the bottom side), 54 nets.
