zuhayrl/EEE4022S_Thesis/PCB/Controller/controller_v2-0/controller.kicad_pcb

## KiCad design PCB/Controller/controller_v2-0/controller.kicad_pcb (2025-08-26)

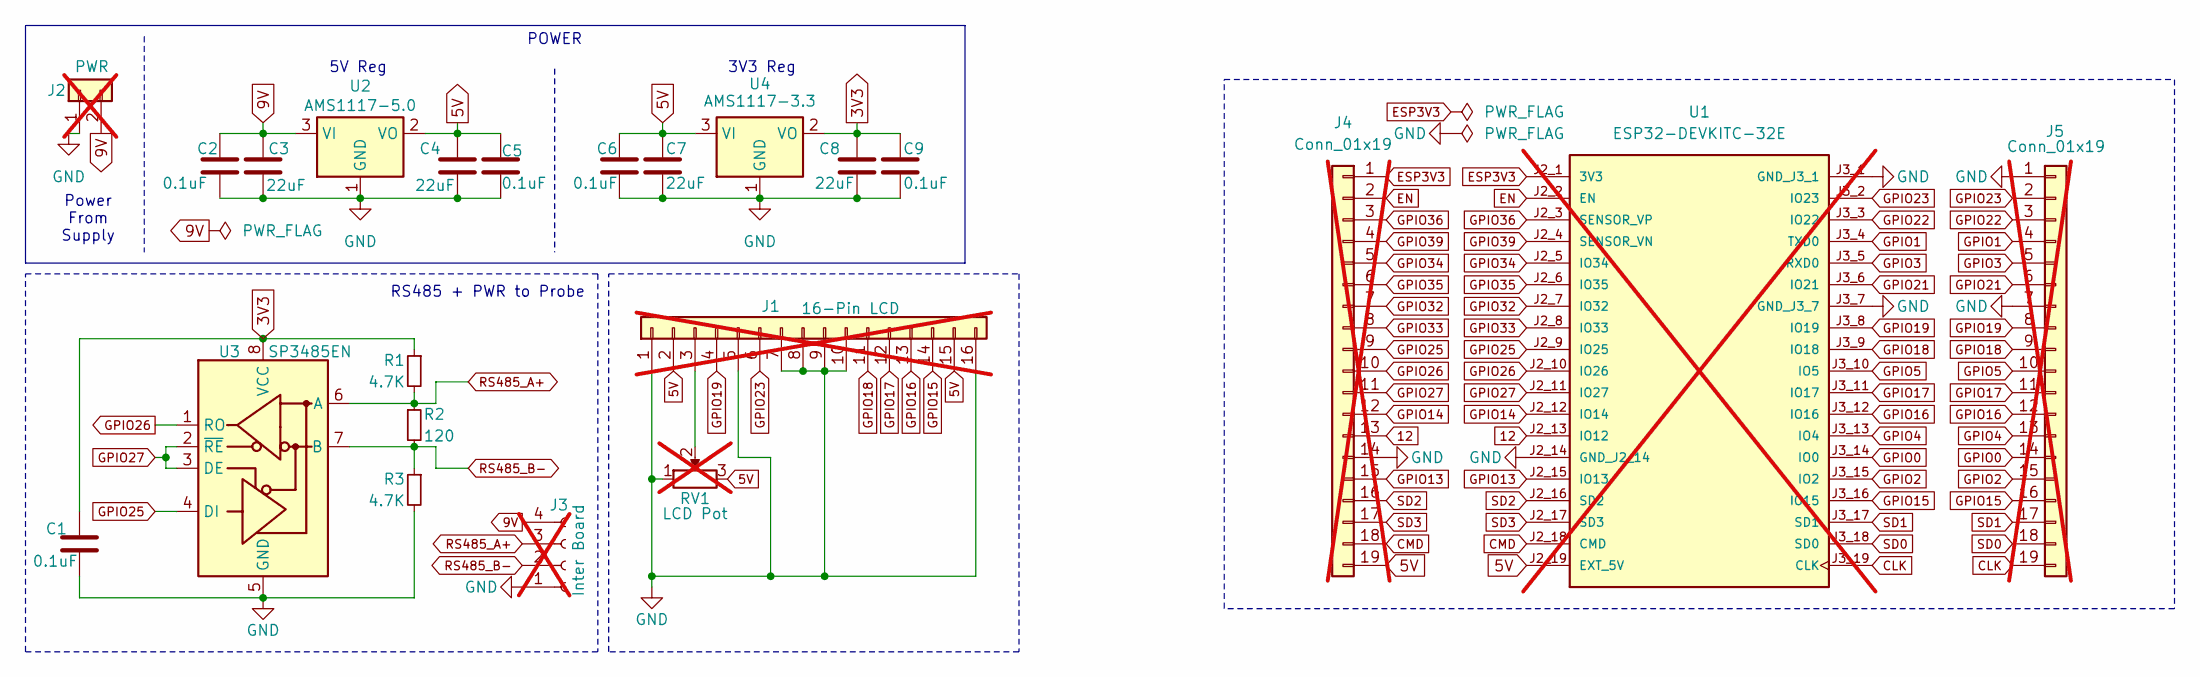
[picture p56: schematic controller.kicad_sch]

Parts:
C1, C2, C5, C6, C9: 0.1uF; C_0402_1005Metric; JLCPCB Part No. C1525
C3, C4, C7, C8: 22uF; C_1206_3216Metric; JLCPCB Part No. C12891
J1: 16-Pin LCD; PinSocket_1x16_P2.54mm_Vertical; not fitted
J2: PWR; PinHeader_1x02_P2.54mm_Vertical; not fitted
J3: Inter Board; PinHeader_1x04_P2.54mm_Vertical; not fitted
J4, J5: Conn_01x19; PinHeader_1x19_P2.54mm_Vertical; not fitted
R1, R3: 4.7K; R_0603_1608Metric; JLCPCB Part No. C23162
R2: 120; R_0603_1608Metric; JLCPCB Part No. C22787
RV1: LCD Pot; 10KPot; not fitted
U1: ESP32-DEVKITC-32E; MODULE_ESP32-DEVKITC-32E-Edited2; PARTREV 1.4; not fitted
U2: AMS1117-5.0; SOT-223-3_TabPin2; JLCPCB Part No. C6187
U3: SP3485EN; SOIC-8_3.9x4.9mm_P1.27mm; JLCPCB Part No. C8963
U4: AMS1117-3.3; SOT-223-3_TabPin2; JLCPCB Part No. C6186

Connections:
3V3: C1.1, C8.1, C9.1, R1.1, U3.8 (VCC), U4.2 (VO)
5V: C4.1, C5.1, C6.1, C7.1, J1.2, J1.15, J4.19, RV1.3, U1.J2_19 (EXT_5V), U2.2 (VO), U4.3 (VI)
9V: C2.1, C3.1, J2.2, J3.4, U2.3 (VI)
12: J4.13, U1.J2_13 (IO12)
CLK: J5.19, U1.J3_19 (CLK)
CMD: J4.18, U1.J2_18 (CMD)
EN: J4.2, U1.J2_2 (EN)
ESP3V3: J4.1, U1.J2_1 (3V3)
GND: C1.2, C2.2, C3.2, C4.2, C5.2, C6.2, C7.2, C8.2, C9.2, J1.1, J1.5, J1.7, J1.8, J1.9, J1.10, J1.16, J2.1, J3.1, J4.14, J5.1, J5.7, R3.2, RV1.1, U1.J2_14 (GND_J2_14), U1.J3_1 (GND_J3_1), U1.J3_7 (GND_J3_7), U2.1 (GND), U3.5 (GND), U4.1 (GND)
GPIO0: J5.14, U1.J3_14 (IO0)
GPIO1: J5.4, U1.J3_4 (TXD0)
GPIO2: J5.15, U1.J3_15 (IO2)
GPIO3: J5.5, U1.J3_5 (RXD0)
GPIO4: J5.13, U1.J3_13 (IO4)
GPIO5: J5.10, U1.J3_10 (IO5)
GPIO13: J4.15, U1.J2_15 (IO13)
GPIO14: J4.12, U1.J2_12 (IO14)
GPIO15: J1.14, J5.16, U1.J3_16 (IO15)
GPIO16: J1.13, J5.12, U1.J3_12 (IO16)
GPIO17: J1.12, J5.11, U1.J3_11 (IO17)
GPIO18: J1.11, J5.9, U1.J3_9 (IO18)
GPIO19: J1.4, J5.8, U1.J3_8 (IO19)
GPIO21: J5.6, U1.J3_6 (IO21)
GPIO22: J5.3, U1.J3_3 (IO22)
GPIO23: J1.6, J5.2, U1.J3_2 (IO23)
GPIO25: J4.9, U1.J2_9 (IO25), U3.4 (DI)
GPIO26: J4.10, U1.J2_10 (IO26), U3.1 (RO)
GPIO27: J4.11, U1.J2_11 (IO27), U3.2 (~RE), U3.3 (DE)
GPIO32: J4.7, U1.J2_7 (IO32)
GPIO33: J4.8, U1.J2_8 (IO33)
GPIO34: J4.5, U1.J2_5 (IO34)
GPIO35: J4.6, U1.J2_6 (IO35)
GPIO36: J4.3, U1.J2_3 (SENSOR_VP)
GPIO39: J4.4, U1.J2_4 (SENSOR_VN)
unnamed: J1.3, RV1.2
RS485_A+: J3.3, R1.2, R2.1, U3.6 (A)
RS485_B-: J3.2, R2.2, R3.1, U3.7 (B)
SD0: J5.18, U1.J3_18 (SD0)
SD1: J5.17, U1.J3_17 (SD1)
SD2: J4.16, U1.J2_16 (SD2)
SD3: J4.17, U1.J2_17 (SD3)

Notes on the sheet:
5V Reg
RS485 + PWR to Probe
Power From Supply
POWER
3V3 Reg

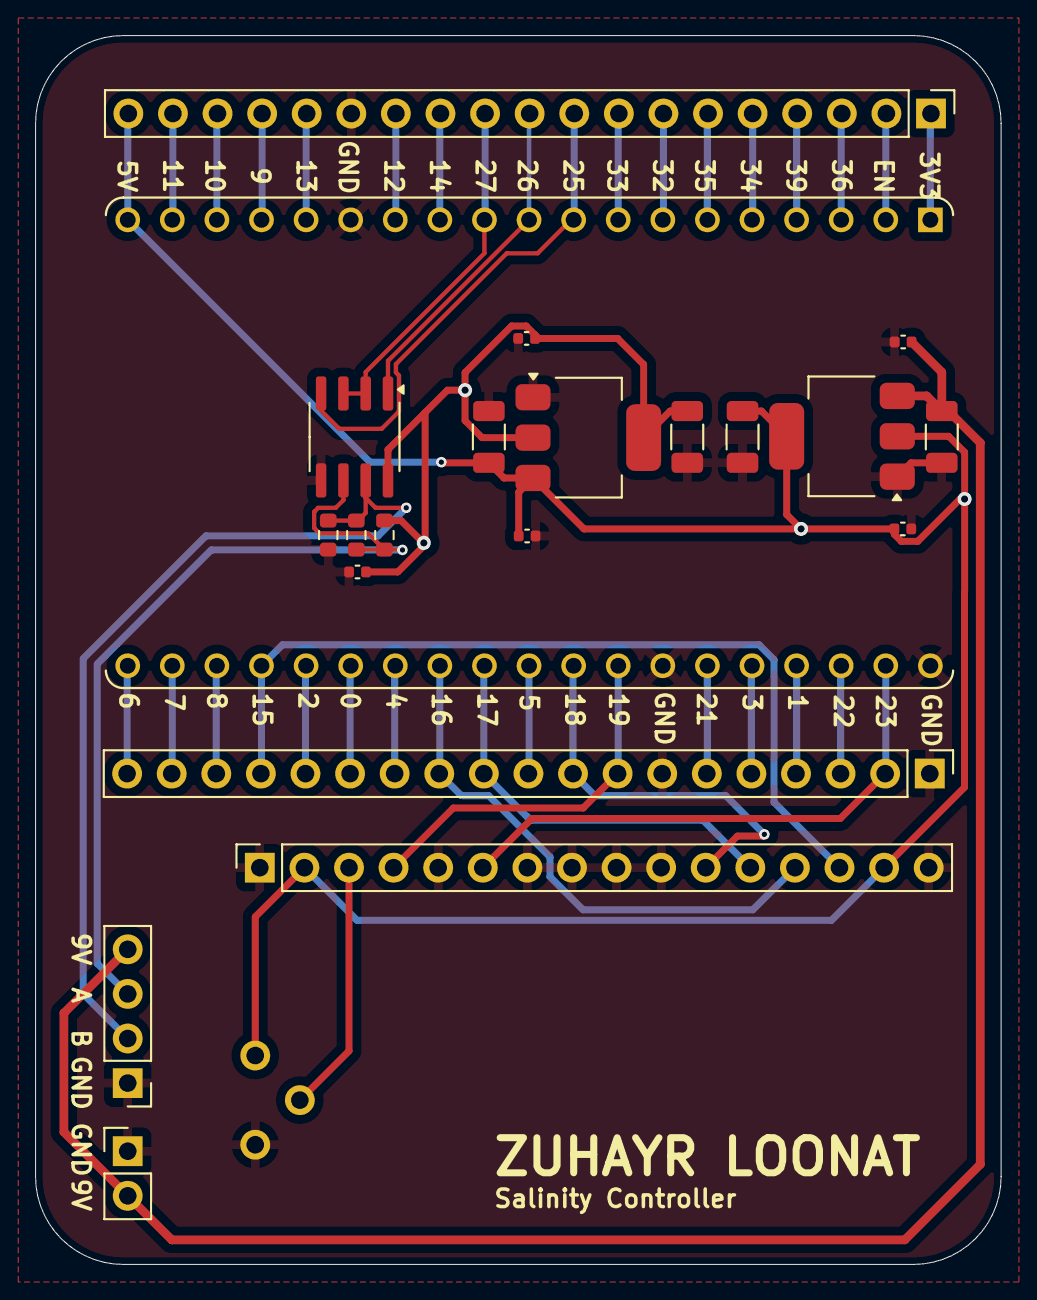
[picture p57: board controller.kicad_pcb from above]

Board: 2 copper layers, 55.0 x 70.0 mm, 22 parts (0 on the bottom side), 41 nets.
