zuhayrl/EEE4022S_Thesis/(commit log)

2025-08-11 Add ADC_DAC_Test example: Implement LED control and DAC output with serial monitoring
2025-08-14 Created Probe PCB
    [probe.kicad_pcb, probe.kicad_sch]
2025-08-14 renamed file
    [probe.kicad_pcb, probe.kicad_sch]
2025-08-16 Probe-Schematic editing
    [probe.kicad_sch]
2025-08-17 Updated PCB
    Added Measuring Circuitry
    [probe.kicad_sch]
2025-08-18 small probe pcb updates
    [probe.kicad_sch]
2025-08-19 Created PCB and New Schematic Version
    [controller.kicad_pcb, controller.kicad_sch, probe.kicad_pcb, probe.kicad_sch]
2025-08-22 All PCBs Done
    [GoldElectrode.kicad_pcb, GoldElectrode.kicad_sch, controller.kicad_pcb, controller.kicad_sch, probe.kicad_pcb, probe.kicad_sch]
2025-08-25 Gerbers and BOMS
    [GoldElectrode-B_Cu.gbl, GoldElectrode-B_Mask.gbs, GoldElectrode-B_Paste.gbp, GoldElectrode-B_Silkscreen.gbo, GoldElectrode-Edge_Cuts.gm1, GoldElectrode-F_Cu.gtl, GoldElectrode-F_Mask.gts, GoldElectrode-F_Paste.gtp]
2025-08-26 BOM, Pos, Gerbers Redone
    [BOM_probe.csv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]
2025-08-28 Order Ready Finally
    [Probe_BOM.xlsx, controller_BOM.xlsx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]
2025-09-24 started coding probe pcb
    [probe.kicad_pcb]
2025-09-27 Refactor code structure for improved readability and maintainability
    [probe.kicad_sch]
2025-09-27 Created Calibration test Code
2025-09-27 Started work on calibration code
2025-09-27 adding adc code
2025-09-28 Created Readme for the adc functionality and added corresponding code
2025-09-28 created seperate files for I2C functions
2025-09-28 added files for adc functions
2025-09-28 added files for rs485 functions and fixed mistakes in other header files
    [adc_driver.c, main.c, rs485_driver.c, rs485_driver.h]
2025-10-12 added driver headers
2025-10-19 Started Voltage Testing
    [VoltageTesting.xlsx]
2025-10-21 added to doc
    [VoltageTesting.xlsx]
2025-10-22 updates to doc
    [SalinityTesting.xlsx, VoltageTesting.xlsx, report_diagrams.kicad_pcb, report_diagrams.kicad_sch]
2025-10-22 update docs
    [report_diagrams.kicad_sch]
2025-10-25 box box box box
    [SalinityTesting.xlsx, adc.csv, dac.csv]
2025-10-25 last push
    [SalinityTesting.xlsx]
2025-10-27 its hammer time
    [ac_output.csv, salinity_data.csv]
2025-10-27 Finish Line
    [ac_output.csv, bode_data.csv, permittivity_data.csv, salinity_data.csv]
